lightminn/ZETIN_Drone/scripts/README.md

# PC 지상국·분석 도구

현행 `dual_imu_cascade_pwm`용 조종·텔레메트리 수집·오프라인 분석 도구다.
처음 시작하면 [전원 인가 벤치 절차](../docs/power_on_bench_procedure.md)를
먼저 읽고, USB로 연결한 DualSense와 `control_dualsense.py`를 사용한다.
이 문서는 2026-09-07 저장소 코드 기준이며 현재 기체에 올라간 빌드나 실기
통과 여부를 뜻하지 않는다. 명령·필드 순서·단위의 정본은
[UDP 프로토콜](../docs/udp_protocol.md)이다.

## 무엇을 실행할까

아래 명령은 저장소 루트에서, 필요한 패키지가 설치된 Python 환경으로 실행한다.
의존성은 [requirements.txt](../requirements.txt)에 있다. `motor_serial.py`는
추가로 `pyserial`이 필요하다.

| 목적 | 도구 | 실행 조건과 출력 |
|---|---|---|
| 조종·stdin 명령·CSV·raw 기록 | `control_dualsense.py` | 현행 기본 지상국. 게임패드 USB 연결, `Drone_Tuning` 접속 |
| 축·버튼 번호 확인 | `gamepad_probe.py` | 드론에 명령을 보내지 않음. 처음 0.7초 손을 떼고 각 입력을 하나씩 확인 |
| 입력값 연속 표시 | `test_dualsense_input.py` | 로컬 입력 진단. 화면의 RX/RY/L2 라벨은 예시 매핑이므로 축 번호를 실측 |
| 게임패드 없는 수동 UDP 콘솔 | `tune_pid.py` | 명령 1회 송신과 상태 표시. RC 자동 송신·CSV 기록·종료 시 자동 `stop` 없음 |
| 텍스트 수신·CSV 기록 | `receive_telemetry.py` | 단독 수신 전용. 조종·정지 명령 없음 |
| 실시간 그래프·CSV 기록 | `monitor_telemetry.py` | GUI 필요. 조종·정지 명령 없음 |
| 비행 CSV 요약·그래프 | `analyze_flight_log.py` | 오프라인. 대상 `flight_log_*.csv` 경로를 명시 |
| 프로브 분포 분석 | `analyze_probe_response.py` | 오프라인 연구용. 결과가 현행 착지컷에 연결되지는 않음 |
| raw 바이너리 → CSV | `decode_imu_raw.py` | 오프라인. 원본 `.bin` 보존, 출력 CSV 생성/덮어쓰기 |
| 자기계 보정 상수 계산 | `magcal_fit.py` | 보정용 raw CSV에서 상수를 출력. 펌웨어를 자동 수정하거나 업로드하지 않음 |
| dual-IMU 루프 진단 | `receive_dual_imu_debug.py` | 전용 `icm42670_dual_loop_debug` 펌웨어·`DUAL_IMU_DEBUG` AP용 |
| 모터 식별용 시리얼 조작 | `motor_serial.py` | 전용 `motor_id_single` 펌웨어, 프로펠러 제거·PSU 전류 제한. 지정 시리얼 포트 확인 |

**드론에 UDP를 보내는 도구는 한 번에 하나만 실행한다.** 펌웨어는 마지막
발신자의 IP/포트를 텔레메트리 목적지로 삼는다. 포트 충돌을 피했더라도
`tune_pid.py`나 수신기의 `connect`가 조종 지상국의 데이터를 가져갈 수 있다.
DualSense 조종 중 상태 확인과 로그 기록도 같은 `control_dualsense.py`에서 한다.

`receive_telemetry.py`와 `monitor_telemetry.py`는 현재 raw 바이너리 분기가
없다. 펌웨어 raw가 켜져 있으면 `ZIMU`·`ZCAL`을 불량 텔레메트리로 집계하며
저장하지 않는다. raw까지 받을 세션은 `control_dualsense.py`를 사용한다.
독립 수신기만 사용할 벤치에서는 모터를 정지한 채 기존 콘솔에서 `raw off`
(`tune_pid.py`에서는 `raw 0`)를 보내고 그 콘솔을 종료한 뒤 수신기를 실행한다.
이 설정은 드론 재부팅 후 유지되지 않는다.

## DualSense 시작·조종·정지

```bash
python scripts/gamepad_probe.py
python scripts/control_dualsense.py
```

첫 명령을 종료한 다음 두 번째 명령을 실행한다. 실행만으로 시동하지 않는다.
`[STATUS]`의 자세·`Armed`·`Faults`를 확인하고 벤치 절차의 시동 조건을 따른다.
게임패드 없이 시작하면 조종 스레드는 종료하지만 stdin·수신은 남는다. 이때
stdin `start`만으로 주기적인 RC가 생기지는 않으므로 비행 조종에 사용하지 않는다.

| 입력 | 현행 동작 |
|---|---|
| X | 지상국이 무장 상태로 보면 `stop`, 아니면 `start` 요청 |
| △ | 자동착륙 하강 중 명시적 `resume` 시도 |
| 왼쪽 스틱 | roll/pitch 목표 각도, 최대 ±15° |
| 오른쪽 스틱 좌우 | yaw 각속도, 최대 ±90°/s. 상하는 사용하지 않음 |
| R2 / L2 | 눌림으로 판정된 동안 스로틀 증가/감소, 일정한 200µs/s |
| R1 / L1 | 누름 엣지마다 스로틀 +1 / −1µs |
| D-pad | roll/pitch 트림 0.2°씩 변경, 각 축 ±10° 제한 |
| PS | 트림을 0으로 초기화 |
| stdin `stop` | 지상국의 무장 추정과 무관하게 `stop` 반복 전송 |
| Ctrl+C | 지상국이 무장 상태로 보는 경우 `stop` 후 종료·로그 닫기 |

RC `rcr` 송신 목표는 **20Hz**(`CTRL_LOOP_HZ=20`)다. 스로틀과 트림 입력은
RC 송신 중에만 처리된다. 버튼 번호는 OS/연결 방식에 따라 확인해야 하며,
현재 코드는 X=b0, △=b3, PS=b12, R1=b5, L1=b4, R2=a5, L2=a2를 쓴다.

stdin에는 [프로토콜의 명령](../docs/udp_protocol.md#지상국--드론)을 입력한다.
`start`·`stop`·`resume`·`th`는 지상국 상태도 함께 갱신하는 별도 경로다.
자기계와 raw 토글은 이 콘솔에서 **`mag on/off`, `raw on/off`**로 입력한다.
그 외 PID 게인, `gains`, `yaw`, `magcal`, `magc` 등은 UDP로 전달된다.
명령 전송 메시지나 `ARMED` 배너는 ACK가 아니다. 실제 적용은 `Armed`,
`Mag_Enabled`, `Trim_*`, `GAINS` 응답 등 해당 텔레메트리로 확인한다.

## 링크가 끊겼을 때

게임패드 분리, 유효 텔레메트리 1.5초 미수신, `Fault_RC` 상승 엣지는
**RC 송신만 중단**한다. 로컬 스로틀은 초기화하지만 `th 1000`이나 `stop`을
자동으로 보내지 않는다. 펌웨어는 자체 RC 타임아웃 조건에 따라 즉시 컷 또는
시간 기반 하강을 수행한다. 하강은 착지를 감지하지 않으며 자세한 조건과
시간 예산은 [프로토콜](../docs/udp_protocol.md)에 있다.

수신·패드 연결이 돌아와도 RC가 자동 재개되지는 않는다. 같은 지상국 세션이
드론을 무장 상태로 보고 있고, 최신 `Failsafe_Phase=1`과 유효한 `Hover_Est`가
있을 때 △ 또는 stdin `resume`으로 복구를 요청한다. 지상국은 RC 송신을 먼저
재개하고, 카운터로 RC 수락을 확인한 뒤 `resume`을 보낸다. 이후 추가 RC
수락과 `Failsafe_Phase=0`을 확인해야 성공을 출력하고 로컬 스로틀을 호버
추정치에 맞춘다. **복귀는 고도·하강속도 복구를 보장하지 않는다.**

확인 시간 초과 메시지는 성공을 뜻하지 않는다. 해당 실패 처리만으로는
재개했던 RC 송신이 꺼지지 않을 수 있으며, 실제 phase를 다시 봐야 한다.
킬이나 재상실은 진행 중 복구를 취소한다. 펌웨어가 이미 컷한 뒤에는
`resume`할 수 없다. 지상국을 재시작하면 로컬 무장 추정도 초기화되므로
비행 중 프로세스 재시작을 복구 절차로 사용하지 않는다.

수동 킬은 stdin `stop`·X·Ctrl+C 경로다. 단 X는 로컬 무장 추정에 따른
토글이므로 **항상 정지만 요청하려면 stdin `stop`**을 사용한다.
드론의 `Armed=0` 확인(시동 직후 유예 제외)이나 `Fault_Critical` 상승 엣지도
지상국 무장 추정이 남아 있으면 `stop`을 보낸다. 자세한 링크 진단은
[지상국 링크 문서](../docs/ground_station_link.md)를 따른다.

## 상태·트림·자기계 읽기

`[STATUS]`는 수신된 상태를 약 1초마다, 무장 중 `[DIAG]`는 약 5Hz로 표시한다.
하강 중 `[AUTO-LAND]`는 매 텔레메트리 샘플을 표시하고 종료 phase는 전이 때
한 번 출력한다. 없는 구형 필드는 `-` 또는 `legacy/unknown`이며 정상값 0이 아니다.

- `Mag=`는 지상국 선택이 아닌 실제 `Mag_Enabled`다. 펌웨어 부팅 기본은 OFF,
  지상국 선택 기본은 ON이다. 시동 요청 전에 선택값을 다시 보낸다.
  OFF 선택으로 시작하려면 `--no-mag`를 쓴다. 기존 벤치 결과와 현재 보정 후
  재검증 범위는 [BMM350 문서](../docs/bmm350_yaw_bench_test.md)에서 확인한다.
- `AGL=`은 거리계 표시다. 신선도 없음은 `-`, 음수 거리 원값은 `OOR/q<품질>`,
  그 외는 `1.23m/q200`처럼 표시한다. 거리·광류는 현재 기록용이며 자동 고도
  제어·착지 판정에 사용하지 않는다.
- `eR/eP`는 목표 각도에서 측정 각도를 뺀 값이다. 목표에는 트림이 이미 포함된다.
  `dG`는 두 IMU의 축별 gyro 차이 중 최댓값이다. 이 20Hz 스냅샷으로 빠른
  프롭 진동·순간 센서 고장을 확정할 수 없다.
- `Trim=`은 드론이 보내온 값이다. 로컬 값과 다르면 `!`가 붙고 0.2초 이상
  간격으로 재전송한다. 유실·거부가 계속되면 표시도 남는다. 첫 완전한 트림
  텔레메트리를 한 번 채택한 뒤에는 로컬 값을 유지하므로 **stdin `trim`이나
  드론 재부팅으로 바뀐 값을 다시 덮어쓸 수 있다.** 같은 세션의 트림 변경은
  D-pad·PS를 사용한다. `start`는 트림을 따로 보내지 않는다.

## 로그 저장과 오프라인 분석

기본 지상국은 `logs/flight_log_<timestamp>.csv`를 기록한다. raw를 처음
받았을 때 같은 타임스탬프의 `imuraw_<timestamp>.bin`을 열고 데이터그램을
그대로 이어 쓴다. 종료 시 `.bin`을 닫고 같은 이름의 `.csv`로 변환한다.
변환 실패는 경고하며 원본 `.bin`은 남는다. 시간은 로그 크기와 실행 환경에
따라 달라진다. 코드의 “10분 세션 약 12초”는 안내값이다.

```bash
python scripts/control_dualsense.py --no-raw --no-mag
python scripts/analyze_flight_log.py logs/flight_log_YYYY-MM-DD_HHMMSS.csv --no-plot
python scripts/decode_imu_raw.py logs/imuraw_YYYY-MM-DD_HHMMSS.bin /tmp/imu.csv
python scripts/analyze_probe_response.py ground.csv air.csv --label ground --label air
python scripts/magcal_fit.py capture.csv
```

각 명령은 서로 별도 용도다. `--no-raw`는 시작 시 `raw 0`을 반복 전송하며
세션 내 raw 파일 기록을 막는다. 이후 `raw on`은 펌웨어 게이트만 켜므로
`--no-raw`로 시작한 세션의 기록을 다시 켜지는 않는다. 기본 실행도 `raw 1`을
자동 재전송하지 않으므로 이전 세션이 껐다면 `raw on`을 직접 입력한다.

`analyze_flight_log.py`의 `--no-plot`은 창을 생략하지만 matplotlib은 여전히
필요하다. 파일을 생략하면 `logs/*.csv` 중 수정시각이 가장 최근인 파일을
선택하므로, raw CSV를 고르지 않도록 경로를 명시한다.

프로브 분석은 실행 시 현재 `.ino`에서 임계를 읽는다. 과거 비행 당시 임계와
같다는 뜻은 아니다. 20Hz에서 관측된 상태 전이 또는 응답값 변화로 이벤트를
추출하므로 일부 이벤트를 놓칠 수 있다. `BLOCKED`·0 응답을 제외하고,
표본 부족·`Hover_Est` 혼합은 판정을 보류한다. 종료코드 0은 분석 실행 성공이며
분포 “통과”를 뜻하지 않는다. `--plot`일 때만 matplotlib을 불러온다.

`magcal_fit.py`는 기본적으로 `Mag_Cal_Active=1`인 raw 행만 사용한다.
`--all`은 보정 전 raw만 따로 추린 파일임을 확인했을 때만 사용한다. 출력의
`95p |B| radial residual`은 자기장 크기 피팅 잔차로, heading 정확도가 아니다.
스로틀 간섭 계수 환산은 입력 좌표계가 맞아야 하며 새 보정 후 모터 벤치로
재검증한다. 로그 좌표계·시간축·결측 해석은 [logs/README.md](../logs/README.md).

## 자동 벤치 스크립트의 실행 범위

`bench_sign_test.py`·`bench_yaw_test.py`·`bench_thrust_ramp.py`는 이전 벤치의
자동화 도구다. 세 스크립트 모두 **WiFi 전환, `trim 0 0`, `start`, 주기적 RC,
종료 시 `stop`**을 실행한다. 출력 경로와 복귀 SSID가 코드에 고정되어 있고
WiFi 복귀 성공을 충분히 확인하지 않은 채 완료를 출력한다. 새 환경에서
그대로 실행하는 첫 진입점으로 사용하지 말고
[현행 벤치 절차](../docs/power_on_bench_procedure.md)와 설정을 먼저 대조한다.

- `bench_sign_test.py`·`bench_yaw_test.py`: 모터 전원 차단·프로펠러 제거 상태의
  텔레메트리 부호 확인용이다. 이 전제를 코드가 물리적으로 확인하지 않는다.
- `bench_thrust_ramp.py`: 프로펠러가 회전하는 고정 시험용이다. EOF에서도
  확인 입력을 통과하고, 종료 램프는 고정 `1200 → 1100 → 1000`이어서 지정한
  `cap_us`가 1200보다 작아도 그 값을 넘을 수 있다. 20Hz 모터 명령 분산에
  근거한 “진동 없음”·다음 시험 권고 출력은 기계 진동·실제 추력·비행 안전의
  검증으로 취급하지 않는다. 이 제한을 해결하기 전에는 초보자 실행 경로에서
  제외한다.

공유 모듈은 `telemetry_schema.py`(파싱·CSV 정규화)와
`failsafe_telemetry.py`(phase·probe 이름과 표시)다. 이들은 실행 도구가 아니다.
[archive/](archive/README.md)의 GPS/TCP 도구는 현행 비행 펌웨어용이 아니다.
