lightminn/ZETIN_Drone/docs/superpowers/plans/2026-07-28-failsafe-vertical-state-strategy.md

# 자동착륙 취약점 8건 해소 전략

2026-07-28. 코드리뷰 수정(커밋 358f2ef~54d6d9c) 이후 남은 구조적 취약점 8건의
해소 전략. 개별 패치 목록이 아니라 **의존 순서가 있는 3개 층**이다.

## 0. 8건은 독립적이지 않다

| # | 취약점 | 뿌리 | 해소되는 곳 |
|---|---|---|---|
| 1 | 임계값이 호버 추력에 비연동 | 수직 상태 없음 | Layer 1 |
| 2 | `saw_impact`에 시간 제약 없음 | 수직 상태 없음 | Layer 1 (문제 소멸) |
| 3 | 지면효과 오검출 | 수직 상태 없음 | Layer 1 (문제 소멸) |
| 4 | `safety_lock` 양 코어 경합 | 독립 | Layer 2 |
| 5 | 타임아웃이 사실상 주 경로 | 수직 상태 없음 | Layer 1 |
| 6 | `Failsafe_Phase` 소비자 없음 | 관측 불가 | Layer 0 |
| 7 | 가속도 보정 없음 | — (Layer 1의 전제) | Layer 1 |
| 8 | 복구 경로 없음 | 독립 | Layer 2 |

1·2·3·5는 한 뿌리다 — **failsafe가 기체의 수직 상태를 모른다.** 고도도
수직속도도 호버추력 추정도 없으니 변하는 양을 고정 상수로 대신하고 있다.

### 왜 적분이 답인가

원래 설계가 실패한 지점이 여기다. 등속 하강과 정지는 **순간** 가속도로
구분되지 않는다(둘 다 1g). 그러나 적분하면 구분된다:

- 등속 하강: `|a| = 1g`, `v_z = 상수 ≠ 0`
- 접지 후 정지: `|a| = 1g`, `v_z = 0`

스파이크 검출은 이 정보를 못 쓰기 때문에 택한 우회로였다. 지면효과도
마찬가지로 갈린다 — 지면효과는 하강을 **감속**시키지만 **정지시키지는
못한다.** v_z는 그 차이를 본다.

### 실현 가능성 검산

`v_z`를 적분으로 얻을 때 지배적 오차원을 따져야 한다.

**자세 오차는 문제가 아니다.** 자세 추정이 θ만큼 틀려도 수직 성분은
`1g·cos(θ)`이므로 오차가 θ의 2차다. θ=2°면 0.0006g = 0.006 m/s², 5초
적분해도 0.03 m/s. (`g·sinθ`는 수평 누설이지 수직이 아니다.)

**지배적 오차는 가속도 스케일 하나다.** 현재 실측 바이어스 +0.8%
(정지 시 `|a|` 중앙값 1.007~1.009g) = 0.078 m/s² → 5초에 **0.39 m/s**.
목표 하강률 0.4 m/s와 같은 크기라 보정 없이는 쓸 수 없다.

정지 시 `|a|`로 스칼라 스케일 보정(`k = 1/|a|_rest`)을 하면 잔차는 0.1%
수준 → 5초에 0.05 m/s. 하강률 대비 12%로 충분하다. **그래서 7번이 선택이
아니라 전제조건이다.**

진입 시 `v_z = 0`으로 리셋하므로 적분 구간은 하강 5초로 제한된다. 비행
전체를 적분하지 않는다.

⚠️ `FS_MAX_MS`를 10초로 올리면 드리프트도 2배(0.1 m/s)가 된다. 판정
임계를 그에 맞춰 재검토해야 한다.

### 스칼라 스케일 보정의 한계 (의도적 선택)

축별 오프셋 보정은 6면 캘리브레이션이 필요하고, 정지 1회 측정으로는
자세를 모르므로 3축 분리가 불가능하다. 반면 **착지 판정과 v_z 모두 `|a|`
기반**이므로 스칼라 스케일만으로 관측된 오차의 대부분을 제거한다. 축별
오프셋은 별도 과제로 남긴다(현재 근거 없음).

## Layer 0 — 관측 가능하게 만들기

**이게 없으면 나머지는 추측이다.** Layer 1의 모든 항목이 여기에 의존한다.

### 0-A. SIL 플랜트에 수직 동역학 추가
`PlantState`에 `z`, `v_z`. 스로틀→추력 모델, 지면 접촉(반력·정지), 지면효과
(고도에 따른 추력 증배)를 넣는다.

지금은 자동착륙을 검증할 수 있는 곳이 실기밖에 없다. 이걸 만들면 하강,
착지, **공중 오검출**, 타임아웃을 전부 자동 검증할 수 있고, 위험해서 실기로는
재현하면 안 되는 시나리오를 안전하게 돌릴 수 있다.

검증 대상 시나리오(최소):
- 정상 하강 → 접지 → `FS_CUT_LANDED`
- 진입 스로틀이 호버보다 높음 → 상승 → 현재 코드로는 타임아웃 (1번 재현)
- 지면효과 구간 통과 중 오검출하지 않음 (3번 재현)
- 돌풍 스파이크 후 잔잔한 구간 → 오검출하지 않음 (2번 재현)

**먼저 현재 코드로 위 넷을 돌려 1·2·3번이 실제로 재현되는지 확인한다.**
재현되지 않으면 내 분석이 틀린 것이므로 Layer 1 설계를 재검토한다.

### 0-B. ~~하강 구간 고속 캡처~~ → **불필요해짐 (2026-07-28)**

착지 판정이 1-C′ 능동 프로브로 바뀌면서 이 항목의 근거가 사라졌다.

관측 대상이 **10~100ms 접지 스파이크 파형**에서 **프로브당 스칼라 응답
하나**로 바뀌었다. 프로브는 400ms마다 일어나고 텔레메트리는 50ms 주기이므로
각 응답이 8회씩 샘플링된다. `Failsafe_Probe_Response_G`(43번 필드)로 이미
나가고 있어 E-4a의 분포 측정에 충분하다.

**보류 조건**: E-4a에서 지면/공중 응답 분포가 겹쳐 원인 진단이 필요해지면
그때 만든다. 그 경우에도 기압센서 쪽이 먼저 검토 대상이다.

### ~~0-B 원안~~ (기록용)
텔레메트리는 50ms(20Hz)인데 접지 스파이크는 10~100ms다. **현행 로그로는
스파이크를 볼 수 없다** — 지금 `docs/power_on_bench_procedure.md` Stage E-4가
지시하는 측정은 실행 불가능하다.

하강 중 원시 `|accel|`(및 `v_z` 추정치)을 1kHz 링버퍼에 담고 컷 이후 UDP로
덤프한다. 5초 × 1kHz × float 2개 = 40KB — RAM 여유(현재 17% 사용) 안이다.
전송은 컷 이후이므로 비행 중 부하가 없다.

이게 `FS_LAND_*` 상수 확정의 유일한 근거다.

### 0-C. `Failsafe_Phase` 표시
`monitor_telemetry.py`와 `analyze_flight_log.py`가 이 필드를 **0번 참조**한다.
그런데 Stage E는 조종자에게 비행 중 실시간으로 보라고 한다. 두 도구에
`Failsafe_Phase`·`Trim_Roll`·`Trim_Pitch`를 추가한다. → **6번**

가장 싸고 벤치를 당장 막고 있는 항목이다.

## 0-A 관문 결과 (2026-07-28, 현재 펌웨어 그대로 측정)

SIL에 수직 동역학을 넣고 V1~V4를 **펌웨어 수정 전에** 돌린 결과다.

| | 시나리오 | 결과 | 판정 |
|---|---|---|---|
| V1 | 정상 하강 | `CUT_LANDED` 2.92s, 접지 1.58s | 5번 **재현 안 됨** |
| V2 | 상승 중 링크 끊김 | **고도 +25.98m**, 27.4m에서 컷 | 1번 **재현** |
| V3 | 지면효과 | 기체가 오히려 상승(+0.82m) | **판정 불가**(시나리오 오설정) |
| V4 | 돌풍 후 잔잔 | 접지 2.309s, **컷 1.901s** (공중 1.0m) | 2번 **재현** |

### 취약점 5는 이미 해소됐다

"모든 자동착륙이 타임아웃으로 끝난다"는 주장은 **구 코드(±0.05g)에 대해서만
맞았다.** 실측 로그로 400ms 확정창이 통째로 허용오차 안에 들어오는 비율:

| 로그 | ±0.05g (구) | ±0.10g (현) |
|---|---|---|
| 040715 | 66.5% | 95.6% |
| 040904 | 68.5% | 92.7% |
| 041032 | 84.9% | 97.1% |

커밋 4174172의 허용오차 확대만으로 안정 조건은 실현 가능해졌다. V1의 성공은
SIL 인공물이 아니라 실측이 뒷받침한다.

⚠️ 부수 정정: LPF가 노이즈를 크게 줄일 것이라는 최초 계산은 **백색잡음
가정이라 틀렸다.** 실측에서 5Hz LPF는 sd를 0.0503 → 0.0470으로 거의 줄이지
못한다. 노이즈의 지배 성분이 5Hz 아래의 실제 기체 운동이기 때문이다.

### 그런데 이게 반대편을 악화시킨다

안정 조건이 쉬워진 만큼(93~97%) 공중 오검출을 막는 것은 `saw_impact` 하나뿐이다.
그리고 V2가 그 문지기가 헐겁다는 것을 보여줬다.

**신규 취약점 9 — `saw_impact`는 접지에 특이적이지 않다.** V2에서 기체가
상승하는 동안 0.501s에 `saw_impact`가 섰다. 상승 가속도가 1g+0.25g를 넘었기
때문이다. 지면 반력이든 상승 가속이든 돌풍이든 **위쪽 가속이면 무엇이든**
접지 증거로 채택된다.

정리하면 같은 결론이다:
- 구 코드: 너무 엄격 → 안 걸림 (취약점 5)
- 현 코드: 안정 조건은 쉬워졌으나 문지기가 비특이적 → **공중에서 걸림** (취약점 2·9)

**가속도 크기만으로는 이 일을 할 수 없다.** Layer 1(v_z)이 유효하다.

### 0-A′ 후속 측정 (진동 모델 + V3 재설계)

SIL에 실측 기반 저주파 진동 모델(기본 OFF, 결정적)을 넣고 다시 측정했다.

**취약점 3 — 반증.** V3를 실제로 하강하게 고쳐 `k_ge`를 0.15/0.25/0.35로 훑었다.

| `k_ge` | 접지 전 최대 \|accel\| | 임계 | 접지 전 impact |
|---|---|---|---|
| 0.15 | 1.0059g | 1.25g | 없음 |
| 0.25 | 1.0254g | 1.25g | 없음 |
| 0.35 | 1.1089g | 1.25g | 없음 |

메커니즘이 분명하다: **하강 스로틀 부족분(−60µs ≈ 추력 −14%)이 지면효과
증가분을 상쇄한다.** 지면효과는 기껏해야 1g 쪽으로 되돌릴 뿐 임계를 넘기지
못한다. 취약점 3은 목록에서 닫는다.

**취약점 5 — 반증(이미 해소).** 노이즈 sd를 0.02/0.04/0.06g로 훑어도 V1은
계속 `FS_CUT_LANDED`로 착지했다. 다만 **검출이 0.71초 지연**된다(2.925s →
3.642s). 0.06g 위의 여유는 이 스윕으로 주장할 수 없다.

**취약점 2·9 — 확정.** V4는 노이즈 ON/OFF 무관하게 **정확히 같은 1.901초**에
공중 컷했다(접지 2.309초, 약 1m 상공). 노이즈가 원인이 아니라 **로직이
원인**이라는 뜻이다.

### v_z 적분의 타당성 (실측으로 확인)

저주파 노이즈를 적분하면 랜덤워크가 커져 v_z가 못 쓸 것이라는 우려가 있었다.
모터 OFF 정지 구간에서 **센서 노이즈 바닥**을 재보니:

    센서 노이즈 바닥 = 0.0006 g   (무장 중 관측 0.03~0.05g보다 두 자릿수 작음)

즉 무장 중의 0.04g는 거의 전부 **실제 기체 운동**이지 센서 오차가 아니다.
실제 운동은 v_z가 추적해야 할 신호지 오차가 아니다. 센서 노이즈만의 적분
드리프트는 τ=0.2s, T=10s에서도 **0.012 m/s**로 무시할 수 있다.

따라서 v_z의 지배 오차는 여전히 **스케일 오차 하나**(0.8% → 5초에 0.39 m/s)이며
1-A로 잡는다. **Layer 1은 실현 가능하다.**

### 갱신된 취약점 현황

| # | 상태 |
|---|---|
| 1 | **확정** (V2: +25.98m 상승) → 1-B |
| 2 | **확정** (V4: 공중 1m 컷, 노이즈 무관) → 1-C |
| 3 | **반증** — 하강 스로틀 부족분이 지면효과를 상쇄. 닫음 |
| 4 | 미측정 (경합) → 2-A |
| 5 | **반증** — 커밋 4174172로 이미 해소. 닫음 |
| 6 | **완료** (커밋 a6599cd) |
| 7 | v_z의 전제조건 → 1-A |
| 8 | 미측정 (복구 경로) → 2-B |
| 9 | **확정** (V2: 상승 중 `saw_impact`) → 1-C |

8건 중 **2건이 반증되어 닫혔고 1건은 완료**됐다. 남은 것은 1·2·4·7·8·9다.

### 남은 숙제

- **V3 재설계**: 진입 스로틀이 호버보다 높아 기체가 상승해버렸다. 지면효과
  구간을 실제로 통과하도록 다시 짜야 3번을 판정할 수 있다.
- **SIL에 진동 모델이 없다**: 현재 accel 주입은 2 LSB dither뿐이라 실측 sd
  0.03~0.05g보다 훨씬 깨끗하다. V1~V4를 현실적으로 만들려면 실측에 맞춘
  노이즈를 넣어야 한다. 특히 **오검출 시나리오는 노이즈 없이는 낙관적으로
  나온다.**
- `k_ge=0.15`(추력 +15%)는 임계 0.25g보다 작아 지면효과만으로는 `saw_impact`를
  못 세운다. 실제 지면효과는 최대 +30%까지 가므로 파라미터 의존적이다.
- `LandDetector`가 `pid_task` 지역변수라 계측 seam이 없어 SIL이 shadow 복제본을
  돌려야 했다. 검증 신뢰도를 위해 관측 가능하게 만드는 편이 낫다.

## Layer 1 — 상수를 추정으로 대체

### 1-A. 가속도 스케일 보정 → **7번**
`calibrate_bias()`는 이미 정지 대기를 하고 자이로만 보정한다. 같은 정지
구간에서 `|a|`를 평균해 `accel_scale = 1.0 / |a|_rest`를 구해 적용한다.
움직임 판정(`BIAS_MOVEMENT_THRESH`)은 그대로 재사용한다.

검증: 보정 후 정지 `|a|` 중앙값이 1.000±0.002g인지.

### 1-B. 호버 스로틀 추정기 → **1번**
무장 상태에서 수평이고 `|a| ≈ 1g`가 유지되는 동안의 스로틀이 곧 호버 추력이다.
이를 LPF로 계속 추적한다(`hover_throttle_est`).

그 위에서 두 상수를 **상대값으로** 바꾼다:
- 하강 목표 = `hover_throttle_est − FS_DESCENT_DELTA_US`
  (진입 스로틀이 아니라 **호버 추정치** 기준. 조종자가 상승 중이었어도
  실제로 하강한다.)
- 지상컷 판정 = `base_throttle < hover_throttle_est − FS_GROUND_MARGIN_US`

추정치가 없을 때(무장 직후, 아직 호버한 적 없음)의 폴백이 필요하다:
추정 유효 플래그가 서기 전이면 **지상으로 간주해 즉시 컷**한다. 호버한 적이
없으면 공중에 있을 수 없다는 논리로, 안전한 쪽 폴백이다.

### ~~1-C. 수직속도 기반 착지 판정~~ → **폐기 (2026-07-28)**

원안은 진입 시 `v_z = 0` 리셋 후 적분해 "`v_z`가 0으로 돌아오면 접지"로
판정하는 것이었다. **수학적으로 틀렸다.** 구현 중 발견했다.

```
v̂z(t) = ∫[진입→t] a_z dt = vz(t) − vz(진입)
```

진입 시 0으로 리셋하면 얻는 것은 절대 수직속도가 아니라 **진입 시점 대비
변화량**이다. 지면에 정지해 있어도 `v̂z = −vz(진입)`이지 0이 아니다.
"`v_z`가 0으로 돌아온다"는 실제로는 "`vz`가 진입 때와 같아진다"를 뜻한다.

전제가 통째로 무너지진 않았다. 호버 중 링크가 끊기면 `vz(진입) ≈ 0`이라
동작한다. 깨지는 것은 진입 시점에 이미 수직으로 움직이던 경우 — **정확히
V2(상승 중)와 V4(하강 중)**, 즉 고치려던 바로 그 시나리오다.

측정도 일치했다. 명세대로 구현하니 V1·V2가 전부 타임아웃으로 갔고, 접촉
충격으로 보조 재고정을 넣으니 바운스가 추정치를 −0.22~−0.36 m/s로 밀어 V1이
다시 실패했다.

**근본 한계**: 가속도계만으로는 "지면 정지 + 스로틀 호버 미만"과 "종단속도
등속 하강"이 정상상태에서 구분되지 않는다. 둘 다 정확히 1g이고 차이는
과도구간뿐인데 돌풍이 그것을 흉내낸다. 적분해도 상대량만 얻으므로 이 벽을
넘지 못한다.

### 1-C′. 능동 스로틀 프로브 (채택) → **2·9번**

수동 관측으로 구분이 안 되면 **능동 시험**으로 구분한다.

**원리**: 지면에 있으면 반력이 추력 변화를 흡수해 스로틀을 더 낮춰도
`|accel|`이 1g에 머문다. 공중이면 추력을 줄이는 즉시 아래로 가속해 1g 미만이
된다. 관측이 아니라 개입이므로 **관측 불가능성 자체가 사라진다.**

**절차**
1. `FS_MIN_DESCEND_MS` 이후부터 `FS_PROBE_PERIOD_MS`(초기 400ms)마다 프로브.
2. `base_throttle`을 `FS_PROBE_DIP_US`(초기 40µs) 낮춰
   `FS_PROBE_DIP_MS`(초기 120ms) 유지.
3. 딥 **직전** LPF된 `|accel|`과 딥 **중**(필터 지연 회피로 앞 ~30ms 제외)
   값의 **차분**을 잰다.
4. 차분 > `FS_PROBE_RESPONSE_G`(초기 0.06g)면 "반응함" = 공중.
5. **연속 `FS_PROBE_CONFIRM_N`회(초기 2) 무반응이면 착지 확정.**

**수치 근거**: 호버 1340µs는 아이들 대비 340µs다. 40µs 딥은 추력의 11.8%
= 0.118g. LPF 잔차 노이즈 0.047g 대비 절대값 판정은 2.5σ로 얇지만, **딥 직전
대비 차분**은 저주파 노이즈가 상쇄돼 훨씬 안정적이다(노이즈의 지배 성분이
5Hz 아래라 400ms 안에서는 거의 공통모드다).

공중에서 딥 120ms 동안의 추가 하강은 0.118g × (0.12s)²/2 ≈ **0.008m**로
무시 가능하다.

**자연히 해결되는 것**
- 돌풍: 프로브 타이밍은 우리가 정하고 돌풍은 그와 무관하다. 연속 2회
  무반응 요구로 오검출 확률이 급감한다.
- 바운스: 튀어 오른 동안은 공중이라 프로브가 반응한다 → 착지로 오인하지
  않는다. 안정 기반 방식이 못 하던 것이다.
- 사람이 붙잡은 경우: 무반응 → 컷. 바람직한 동작이다.
- 진입 시점 수직속도: **무관하다.** 절대 속도를 알 필요가 없다.

**실패 방향이 안전하다.** 프로브가 계속 반응하면(공중) 착지를 선언하지 않고
타임아웃으로 간다. 무반응이어야만 컷한다.

**가드**: `base_throttle − FS_PROBE_DIP_US < 1000`이면 딥을 만들 수 없어
판별 불가다. 프로브를 건너뛰고 타임아웃 백스톱에 맡기되 그 사실을
텔레메트리로 드러낸다.

**남는 위험**: 키 큰 풀처럼 부분적으로 받치는 지면에서는 반응도 부분적이다.
`FS_PROBE_RESPONSE_G`가 그 경계를 정하며 벤치 조정 대상이다.

### 1-C′ 측정 결과와 **가장 큰 남은 위험** (2026-07-28)

SIL에서 전 시나리오가 통과했다(25/25). V4의 공중 컷이 사라졌고(접지 5.181s
→ 컷 6.221s), V2의 접지~컷 지연이 1.794s → **0.959s**로 줄었으며, 신규 V5는
바운스 중 프로브가 0.1147g로 반응해 무반응 카운트를 1→0으로 리셋하는 것을
확인했다 — 설계가 주장한 바로 그 동작이다.

**그러나 판정 여유가 얇다.**

| | 프로브 응답 |
|---|---|
| 지면(정착 후) | 0.0379 ~ 0.0512g |
| 공중 | 0.0625 ~ 0.1390g |
| 임계 | **0.0600g** |

최대 지면 응답(0.0512g)과 최소 공중 응답(0.0625g)의 간격이 **0.011g뿐이다.**
지면이 완전히 무응답이 아닌 이유는 물리적이다 — 추력이 줄면 착륙장치(SIL에서는
스프링-댐퍼)가 살짝 더 눌리며 과도응답을 낸다. 실제 기체도 같다.

따라서 **`FS_PROBE_RESPONSE_G`와 `FS_PROBE_DIP_US`는 벤치 실측 없이 신뢰할 수
없다.** 위 수치는 추정 파라미터(질량 0.3466kg, `k_ground` 80N/m)에 의존한다.

벤치에서 확정할 것:
1. 지면에 놓고 자동착륙을 유도해 **지면 응답 분포**를 잰다(수십 회).
2. 손에 들고(공중 대용) 같은 것을 재 **공중 응답 분포**를 잰다.
3. 두 분포가 겹치면 `FS_PROBE_DIP_US`를 키운다(40→60µs면 응답이 1.5배).
   `CTRL_MARGIN`(150) 미만이어야 하며 `static_assert`가 강제한다.
4. 겹침이 해소되지 않으면 **기압센서를 다는 편이 옳다.** 그때는 프로브를
   제거하고 고도원으로 교체한다.

여유가 얇은 쪽으로 틀리면 **타임아웃 컷**이 되므로 실패 방향은 안전하다.
공중 오검출이 되려면 공중에서 연속 2회 응답이 임계 아래로 떨어져야 하는데,
측정된 공중 최소값 0.0625g는 임계 바로 위다 — **이 경계가 벤치의 최우선
확인 항목이다.**

## Layer 2 — 구조 정리 (Layer 0·1과 독립)

### 2-A. `safety_lock` 단일 writer → **4번**
`fs_phase`와 같은 모양의 경합이 그대로 남아 있다. `pid_task`가 765·836·859·
894행에서 `true`를, `udp_task`가 1252행에서 `false`를 쓴다. `fs_phase`에
적용한 것과 같은 방식(요청 플래그를 Core 0이 세우고 실제 전이는 Core 1이
수행)으로 정리한다.

### 2-B. 복구 경로 → **8번**
링크가 살아나도 자동 복귀는 위험하다(하강 중 재진입 반복). 명시적 `resume`
명령으로만 `FS_DESCENDING → FS_NONE` 복귀를 허용한다. 조건: RC가 실제로
살아있고(최근 수신), 자세가 정상이며, IMU가 살아있고, `hover_valid`일 것.

복귀 스로틀은 `hover_est`로 둔다. 하강 스로틀 그대로면 조종자가 `th`를 보낼
때까지 계속 내려가고, 임의로 높이면 튀어오른다. `hover_est`가 유일하게 근거
있는 값이다.

#### ⚠️ resume은 고도를 되찾지 못한다 (2026-07-28 정정)

최초 합격 기준을 "하강이 멈추고 고도가 유지되는지"로 썼는데 **틀렸다.**
`hover_est`는 하강 **가속도**를 0으로 만들 뿐 이미 쌓인 **속도**는 없애지
못한다. 고도·수직속도 피드백 없이 고도 유지는 불가능하다. 앞의 v_z 적분
오류와 같은 종류다 — 변화율과 그 적분을 혼동했다.

하강 가속도 = `−g × FS_DESCENT_DELTA_US / (hover − idle)`
= `−9.81 × 60/340` = **−1.731 m/s²** (공기저항 무시, 초기 구간)

| resume 시점 | 잔류 하강속도 |
|---|---|
| 0.5초 | −0.87 m/s |
| 1.0초 | −1.73 m/s |
| 2.0초 | −3.46 m/s |

**늦게 resume할수록 쓸모가 없다.** 실무 지침: 링크가 돌아오면 즉시
resume하고, 곧바로 스로틀을 올려 고도를 회복한다. resume 자체는 "더 빨리
내려가는 것을 멈출" 뿐이다.

따라서 V6의 합격 기준은 다음으로 정정한다:
- `fs_phase`가 `FS_DESCENDING → FS_NONE`이 된다
- `base_throttle`이 `hover_est`로 복원된다
- **하강 가속도가 0 근처로 억제된다** (고도 유지가 아니라)
- 잔류 하강속도와 그 후 고도 손실을 **수치로 보고**한다

## 실행 순서

```
0-C (표시)        ─┐  벤치를 당장 막고 있음. 먼저.
0-A (SIL 수직)    ─┼─→ 1-B (호버 추정) ─→ 1-C′ (능동 프로브)
0-B (고속 캡처)   ─┘   1-A (스케일 보정)
2-A, 2-B          독립. 아무 때나.
```

엄격한 의존은 하나뿐이다: **0-A 없이 1-C′를 만들면 검증할 곳이 없다.**

1-A(스케일 보정)는 폐기된 v_z 적분의 수치적 전제조건이었다. 1-C′는 절대
속도를 쓰지 않으므로 더 이상 전제조건이 아니다. 다만 자세추정 신뢰도
판정과 프로브 차분의 기준선 정확도에 여전히 도움이 되므로 유지한다.

## 검증 원칙

- 각 항목마다 회귀 테스트를 먼저 RED로 확인한 뒤 GREEN으로 만든다.
- 핵심 가드는 변조로 판별력을 증명한다(이번 리뷰에서 이게 유일하게
  효과적이었다).
- **0-A 완료 후, 현재 코드로 1·2·3번이 SIL에서 실제로 재현되는지 먼저
  확인한다.** 재현되지 않으면 분석이 틀린 것이다.

## 이 전략이 해결하지 못하는 것

- **위치 유지는 여전히 불가능하다.** 위치 센서가 없어 바람에 흘러간다.
  "제자리 착륙"은 이 전략 이후에도 성립하지 않는다.
- 축별 가속도 오프셋(6면 캘리브레이션 필요)은 범위 밖이다.
- 기압센서를 달면 절대 고도와 수직속도를 직접 얻어 능동 프로브 없이 착지를
  판정할 수 있다(PX4·ArduPilot이 쓰는 방식). 1-C′는 하드웨어 추가 없이
  같은 문제를 푸는 대안이며, 기압센서를 나중에 달면 프로브를 제거하고
  교체할 수 있다. 이번 범위에는 넣지 않는다.

---

# 2차 감사 결과 (2026-07-28, 적대적 재검증)

Layer 0~2 완료 후 독립 감사에서 결함 6건이 나왔다. 2건은 이미 고쳤다
(`16cd3c2` stop이 대기 중 resume 미취소, `67e26e5` 지상국에서 resume 도달
불가, `a04b3d0` over-tilt 커버리지 구멍).

## R1. 프로브 딥이 절대값이라 무거운 기체에서 공중 오검출 (최우선)

**증상**: 하강 중 접지 전에 `FS_CUT_LANDED`. 최악 사례 고도 1.4029m,
하강속도 −2.2470m/s, 접지 0.353초 전.

**빈도 실측** (진입 노이즈 위상 100개씩 스윕):

| 노이즈 sd | 질량 1.0× | 질량 1.3× |
|---|---|---|
| 0.02g | 0% | 0% |
| 0.04g | 0% | 4% |
| 0.06g | 0% | 6% |
| 0.08g | 0% | 12% |

**기전**: 프로브 신호는 `dip/(hover − 1000)`에 비례한다. 질량이 늘면 호버가
올라가(1340→1442) 같은 40µs가 11.8%에서 9.05%로 약해지고, 차분이 노이즈에
묻힌다. 실패 시 프로브 응답은 0.0167g/0.0195g로 임계 0.06g보다 훨씬 낮았다.

**이건 1-B에서 고친 것과 같은 실수다.** 하강량은 호버 상대로 바꿔놓고 프로브
딥은 절대값으로 남겼다.

**검증된 수정 — 딥을 호버 대비 비율로**:

| 질량 | 호버 | 고정 40µs | 비례 11.8% |
|---|---|---|---|
| 0.7× | 1238 | 0% | 0% (28µs) |
| 1.0× | 1340 | 0% | 0% (40µs) |
| 1.3× | 1442 | **12%** | **0%** (52µs) |
| 1.6× | 1544 | **23%** | **0%** (64µs) |

`FS_PROBE_DIP_US`(절대) → `FS_PROBE_DIP_FRAC`(= 0.118, `hover_est − 1000`의
비율). 런타임 계산이므로 `static_assert` 대신 `CTRL_MARGIN` 미만으로 클램프하고
측정 가능한 하한도 둔다.

**추가 방어 — 1g 근처 veto**: 착지 확정의 **필요조건**으로 LPF된 `|accel|`이
1g±tol 안일 것을 요구한다. 지면에 정지하면 반드시 1g다. 위 실패 사례는
`accel_min=0.7148g`였으므로 이 veto가 막았다. 이건 원래 설계 결함(1g 복귀를
**충분**조건으로 쓴 것)과 다르다 — 필요조건으로만 쓴다.

## R2. 호버 추정기 오염 → 공중에서 즉시 컷

**증상**: 실제 호버 1340µs인데 1500µs 등속 상승을 4.5초 학습하면
`hover_est=1464`. 지상컷 경계가 1464−120=1344가 되어 **현재 스로틀 1340이
그보다 낮으므로 공중에서 `RC TIMEOUT -> GROUND CUT`**이 난다. 자동착륙이
아니라 즉시 컷이다.

**조건이 이국적이지 않다.** 등속 상승은 `|accel|≈1g`, 수평, 스로틀>1150을
모두 만족한다. 정상 비행 중 1.5초면 후보 시간이 찬다. 추정기는 수직속도도
고도 변화도 보지 않는다.

**수정 — `hover_est`의 두 용도를 분리한다**:
- **하강 목표**: `hover_est` 유지. 틀려도 실패 방향이 안전하다(하강한다).
- **지상컷 판정**: `hover_est` 상대 대신 **보수적 절대 하한**을 쓴다. 너무
  높은 `hover_est`가 공중 즉시컷을 만드는 경로를 끊는다. 최악은 지상에서
  컷 대신 하강을 5초 도는 것 — 불쾌하지만 추락이 아니다.

`hover_est`가 낮게 오염되면 하강이 과격해진다(−198µs). 후보 스로틀이 현재
추정치에서 크게 벗어나면 배제하는 게이트를 함께 검토한다.

## R3. `start` pending-arm 경합

`start`의 첫 분기가 `if (!safety_lock)`만 본다. arm 요청이 대기 중이면
`safety_lock`은 아직 true이므로 **중복 `start`가 already-armed로 안 걸리고
초기화 분기를 다시 실행**한다. Core1이 그 사이 잠금을 풀면 비행 중에
fault latch·스로틀 창·목표각·`hoverTracker`가 재설정된다. `hoverTracker`는
비-volatile 다중 필드 구조체라 명백한 data race다.

**수정**: 가드를 `!safety_lock || safety_arm_requested`로.

## R4. 누적 백스톱 없음

`FS_MAX_MS`는 에피소드별 5초다. `elapsed=4999ms`에 resume을 넣으면 그
에피소드의 타임아웃을 건너뛴다. 실측으로 최초 진입 후 **21.5초** 모터 on을
연장했다. 매 에피소드마다 fresh RC와 명시적 resume이 필요하므로 자동으로
일어나지는 않는다.

**수정**: 최초 진입 시각을 resume이 지우지 않는 별도 변수로 두고, 그로부터
절대 상한(예: 3×`FS_MAX_MS`)을 넘으면 resume을 거부한다.

## R5. 프로브의 누적 하강 비용

무프로브 대비 5초에 **2.9658m**(13.7%) 더 내려간다. 완료 프로브 10회,
딥 누적 1.2초. 딥 구간 내부 변위 합은 0.083m뿐인데, 각 딥이 만든 추가
하강속도가 이후에도 남아 누적된다.

**단 이건 수직 항력이 없는 SIL 결과라 과대평가다.** 실기는 항력이 있어 더
작다.

**수정 후보**: 하강 목표를 듀티 보정한다 —
`descent = hover_est − delta + dip×duty`로 두면 프로브 주기 평균 스로틀이
의도한 하강 스로틀과 같아진다. 새 동작을 추가하지 않는 한 줄 보정이다.

## 남은 해석 한계

- 실기 노이즈가 합성 1.1~7.3Hz 파형과 같은 위상·형상을 얼마나 자주 만드는지
  모른다. 위 빈도표는 이 SIL 모델 안에서의 값이다.
- R2의 오염 조건을 실기가 얼마나 자주 만족하는지 미측정.
- R3의 듀얼코어 인터리빙은 실제 ESP32-S3 스케줄에서 캡처하지 않았다.

---

# 3차 감사 결과 (2026-07-28)

2차 감사 수정(`16cd3c2`, `67e26e5`, `a04b3d0`, `4396f9a`)이 만든 새 경로를
대상으로 했다. Codex 가 콘텐츠 필터 오탐 2회·타임아웃 1회로 완주하지 못해
상당 부분을 직접 수행했다.

## 정상으로 확인된 것

| 항목 | 결과 |
|---|---|
| 누적 예산이 재시동 때 리셋되는가 | 정상. `fs_first_enter_ms` 가 `wasLocked && !safety_lock` 에서 리셋 |
| 지상국 락 순서 역전 | 없음. 중첩·간접 모두 `safety_cmd_lock → telem_lock` 한 방향 |
| 지상컷 절대 1150 이 벤치 위험을 되살렸는가 | 회귀 아님. 이전 상대 기준은 손 파지 시 `hover_est ≈ 현재 스로틀`이라 **지상컷이 사실상 안 걸렸다.** 절대 기준이 그 구멍을 메운다 |
| 딥 클램프 경계 | 상한은 도달 불가(`hover_est=1900`에서도 106µs < 149). 하한은 `hover_est ≤ 1169`에서만 걸리는데 그때도 실효 비율이 11.8% 부근이라 무해 |
| `stop` 이 대기 중 arm 요청 취소 | 정상. `requestSafetyDisarm()` 이 arm·resume 요청을 함께 지운다. 복구 경로는 `stop` → `start` |
| 1g veto 와 바운스 상호작용 | 성질 유지. V5 에서 0.25m 상공 프로브가 0.1147g 로 반응해 카운트 리셋 |
| 커버리지 (지상컷 경계 ±, 예산 상한, 딥 하한) | 4건 변조 모두 전체 테스트가 검출 |

## R6. 부드러운 지면이 능동 프로브를 무력화한다 (신규, 미수정)

**증상**: 접지했는데 착지가 확정되지 않고 백스톱 타임아웃으로 끝난다.
**접지 후 프롭이 3.9초 더 돈다.**

**측정** (V1 기반, `k_ground` × 기울임 × 노이즈 36조합):

| `k_ground` | 결과 |
|---|---|
| 10 / 20 / 40 N/m | **18/18 전부 `FS_CUT_TIMEOUT`** (접지 4.5초, 컷 8.5초) |
| 80 / 200 / 400 N/m | 전부 `FS_CUT_LANDED` |

기울임(0/5/10°)과 노이즈(0/0.04g)는 영향이 없었다. **오직 지면 강성만이
변수다.**

`k_ground = 40 N/m`은 0.4m/s 접지에서 압축 **3.7cm** — 잔디나 흙에서 흔한
값이고 기본값 80의 절반이다.

**원인은 veto 가 아니라 프로브다.** veto 를 제거해도 18/36 그대로다. 부드러운
지면은 추력을 줄이면 눌려주므로 **공중과 구분 불가능한 반응**을 낸다. 설계
문서에 "부분 지지 지면" 한계로 적어둔 것이 정량화된 것이다.

**실패 방향은 안전하다** — 백스톱이 여전히 컷한다. 그러나 접지 상태로 4초간
프롭이 도는 것은 원래 지상 즉시컷으로 막으려던 위험과 같은 종류다.

**수정하지 않았다.** 임계를 낮추면 공중 오검출이 악화되고, 상대 기준 판정
같은 대안은 실기 데이터 없이 정할 수 없다. **Stage E-4a 를 실제 착륙면에서
수행해 결정할 사안이다.**

## 벤치 절차에 반영해야 할 것

1. **E-4a 는 실제 착륙할 지면에서 해야 한다.** 딱딱한 바닥에서 잰 분포로
   잔디 착륙을 판단할 수 없다.
2. **E-4a 의 "손에 들고 공중 응답 측정"은 그대로 하면 무효다.** 손에 든
   상태도 호버 후보 조건(수평·1g·스로틀>1150)을 모두 만족하므로 `hover_est`
   가 **손 파지 스로틀**을 학습한다. 딥은 `0.118 × (hover_est − 1000)` 이므로
   1250 에서 재면 30µs, 실제 비행 1340 에서는 40µs — **25% 다른 딥으로 잰 두
   분포를 비교하게 된다.** 반드시 실제 호버로 `hover_est` 를 확정한 뒤,
   텔레메트리 `Hover_Est` 가 같은 값일 때 잰 측정만 비교한다.
3. 잔디에서 `Phase=3`(타임아웃)으로 끝나고 프롭이 약 4초 더 도는 것은 현재
   설계의 알려진 동작이다. 놀라지 말고 기록한다.

# 6차 감사 결과

5차까지는 "이 변수/이 명령이 의심스럽다"를 추적했다. 6차는 **아직 전수로 훑지
않은 두 축**을 골랐다: 상수끼리의 제약, 그리고 텔레메트리 43필드의 tick 일관성.

## R7. `FS_LAND_LPF_ALPHA`가 프로브 감도를 숨어서 결정한다

프로브는 딥 직전 `|accel|`과 딥 중 최솟값의 차분이 `FS_PROBE_RESPONSE_G`(0.06g)를
넘으면 공중으로 본다. 그런데 그 차분의 크기 자체가 LPF 상수에 달려 있다:

```
response = FS_PROBE_DIP_FRAC × (1 − exp(−FS_PROBE_DIP_MS × FS_LAND_LPF_ALPHA / 1ms))
```

PID 루프가 1kHz라 `alpha`는 ms당 값이고 `FS_PROBE_DIP_MS`도 ms이므로, 둘의 곱이
곧 "딥이 지속되는 시정수 개수"다. 현재 120 × 0.03 = **3.6τ** → 계단의 97%를 본다.

SIL 실측(V2, 고도 2~3m 정상 하강):

| `FS_LAND_LPF_ALPHA` | 공중 프로브 응답 | 임계 0.060g 대비 | SIL 실패 테스트 |
|---|---|---|---|
| **0.03 (현재)** | 0.1146g | 1.91× | 0건 |
| 0.02 | 0.1076g | 1.79× | 0건 |
| 0.01 | 0.0789g | 1.32× | **1건 (vibration)** |
| 0.005 | 0.0464g | **0.77× → 공중을 지면으로 오판** | 3건 |

`alpha=0.005`에서 연속 무반응 카운터가 **고도 3.08m에서 이미 2에 도달**한다.
해석적 경계는 `alpha > 0.0060`이다.

**이 결함의 본질은 테스트가 잘못된 방향을 가리킨다는 것이다.** `alpha`를 0.01로
낮췄을 때 실패하는 유일한 테스트는
`vibration: configured sd survives the firmware 5Hz LPF`이고, 그 테스트의 주장은
*"필터가 노이즈를 별로 안 깎는다"*이다. 노이즈를 줄이려고 `alpha`를 낮춘 사람에게
그 실패 메시지는 "이 기준을 완화하라"로 읽힌다. 프로브 감도를 지키는 테스트는
하나도 없었다.

`FS_LAND_LPF_ALPHA`는 문서상 "전부 벤치 조정 대상" 상수 중 하나다(152행).

**가드는 한 방향만 묶는다.** 추가한 `static_assert` 두 개는 alpha가 **낮아지는**
쪽(프로브 감도 상실 → 공중 컷)만 막는다. alpha를 크게 올리면(예: 0.10) 필터가
노이즈를 그대로 통과시켜 공중 반응이 아니라 **지면에서 거짓 반응**이 나고 착지
확정이 안 된다. 그 방향은 SIL V1이 잡고(alpha=0.10에서 1건 실패) 실패 방향도
안전하다(지면 타임아웃). 그래서 컴파일 타임 가드는 위험한 쪽에만 걸었다.

## R7b. 1g veto는 등속 하강에서 프로브의 두 번째 방어가 아니다

R1(4차)에서 "비례 딥과 1g veto 두 방어가 있고 둘 다 없앨 때만 12%가 재현된다"고
적었다. 그 측정은 **가속 하강**에서 한 것이다. 등속 하강에서는 성립하지 않는다.

등속 하강의 비력은 정확히 1g이므로 `pre_dip_g = 1.0`이고, 따라서

```
response = pre_dip_g − filt = 1.0 − filt = |1 − filt|
```

즉 **프로브 판정과 veto 판정이 같은 하나의 수를 서로 다른 임계로 재는 것**이 된다.
`failsafe_land.h`를 직접 구동해 확인:

| alpha | response | 프로브 판정 (>0.060) | \|1−filt\| | veto (≤0.100) | 결과 |
|---|---|---|---|---|---|
| 0.030 | 0.1149g | AIRBORNE | 0.1149 | **BLOCKS** | 착지 안 함 |
| 0.020 | 0.1076g | AIRBORNE | 0.1076 | **BLOCKS** | 착지 안 함 |
| 0.015 | 0.0988g | AIRBORNE | 0.0988 | passes | 착지 안 함 |
| 0.010 | 0.0827g | AIRBORNE | 0.0827 | passes | 착지 안 함 |
| 0.005 | 0.0533g | **ground(오판)** | 0.0533 | passes | **공중 착지 확정** |

veto 임계(0.10)가 프로브 임계(0.06)보다 **느슨**하므로, 프로브가 위험한 방향으로
틀리는 순간(response ≤ 0.06)에는 자동으로 `|1−filt| ≤ 0.06 ≤ 0.10`이 되어 veto가
반드시 통과한다. **등속 하강에서 veto는 프로브 오판을 원리적으로 절대 잡을 수
없다.**

임계를 조여도 안 된다. 지면에서도 `pre_dip ≈ 1.0`이고 응답이 0.038~0.051g이므로
"지면"과 "프로브가 실패한 공중"은 이 두 측정으로는 **구분 불가능한 같은 서명**을
낸다.

veto가 실제로 값을 하는 구간은 `|pre_dip − 1|`이 큰 경우 — 가속 하강(V2에서
기준선 0.79g), 접지 과도, 기울임 — 이다. 471행의 "추가 방어" 서술은 그 범위에서만
맞다.

**따라서 등속 하강에서 공중 모터컷을 막는 방어는 프로브 응답 여유 하나뿐이다.**
R7의 `static_assert`는 있으면 좋은 것이 아니라 **그 유일한 방어를 지키는 장치**다.

## R8. `HOVER_MIN_THROTTLE_US`가 프로브 가용성의 하한이다

`updateLandDetector`는 `base_throttle − dip < 1000`이면 `FS_PROBE_UNAVAILABLE`로
가고 그 뒤 영원히 착지를 확정하지 못한다(백스톱 컷으로만 끝난다).

이 조건을 풀면 `hover_est < 1080`이다. `hover_est`는 정의상 항상
`HOVER_MIN_THROTTLE_US`보다 크므로 현재 1150에서는 도달 불가능하다. 여유는
**70µs뿐**이고, `HOVER_MIN_THROTTLE_US`는 Stage E-0의 조정 대상이다.

제약: `HOVER_MIN_THROTTLE_US ≥ 1000 + FS_DESCENT_DELTA_US + FS_PROBE_DIP_MIN_US`
(= 1080). 가드 없었다.

## R9. 프로브 확정이 백스톱 안에 들어간다는 보장이 없었다

착지 확정 최단 시각 =
`FS_MIN_DESCEND_MS + FS_PROBE_PERIOD_MS × (FS_PROBE_CONFIRM_N − 1) + FS_PROBE_DIP_MS`
= 1000 + 400 + 120 = **1520ms** < `FS_MAX_MS`(5000).

`FS_PROBE_PERIOD_MS`를 2000으로 올리거나 `CONFIRM_N=4 / PERIOD=1500`으로 바꾸면
**착지를 절대 확정하지 못한다**. SIL이 각각 4건/5건 실패로 잡고 실패 방향도
안전하다(지면에서 타임아웃). 관계식만 코드에 없었다.

**처음 쓴 식은 틀렸다.** `PERIOD × (CONFIRM_N − 1)`로 적었더니 period=2000이
3120 < 5000으로 통과했는데 SIL은 3건 타임아웃이었다. 원인은 **접지 전에 버려지는
공중 프로브**를 세지 않은 것이다 — V1에서 첫 프로브(elapsed=1000)는 접지
(elapsed≈1087) 전이라 공중 반응을 내고 버려진다. `× CONFIRM_N`으로 고쳐 공중
프로브 1회분을 예산에 넣었고, 두 변조 모두 컴파일 타임에 잡힌다.

**이건 필요조건일 뿐 충분조건이 아니다.** 접지 시각이 런타임 값이라 접지가 늦으면
여전히 타임아웃이 날 수 있다. 그쪽은 SIL V1/V2/V4가 잡는다. 이 오류는 변조
검사(`period=2000`이 컴파일을 통과하는지)로 발견했다 — assert를 넣고 통과하는
것만 확인했다면 못 잡았을 것이다.

## R10. 지상국 `arm()`이 락 없이 무장 상태를 공개한다

`disarm()`과 `stop_streaming_only()`는 `safety_cmd_lock`을 잡고
`is_armed`/`is_streaming`을 바꾸는데 `arm()`만 아무 락도 잡지 않는다.

조종 스레드의 arm과 텔레메트리/stdin 스레드의 disarm이 겹치면 disarm의 `stop`이
먼저 나가고 arm의 `reliable_send("start")` 재전송이 나중에 도착할 수 있다. 드론은
무장되는데 지상국은 `is_armed=False`로 믿는다. RC를 안 보내므로 500ms 뒤 RC
타임아웃이 나고 그 시점엔 `hover_valid`가 없어 즉시 컷이라 피해는 프롭 0.5초
회전으로 제한되지만, **조종자가 기체에 손을 뻗는 바로 그 상황이다.**

부수적으로 `last_arm_time`이 `is_armed`보다 **나중에** 대입되어, 다른 스레드가
`is_armed=True`와 옛 `last_arm_time`을 함께 보고 1.5초 grace를 이미 지난 것으로
오판해 "시동 거부" 오보를 낼 수 있다.

## R11. `mag_reference_pending`이 코어 간에 유실될 수 있다

Core 1이 읽고(1004행) 지우는(1008행) 사이에 Core 0의 set이 끼면 그 set이 사라진다.
결과는 `angleZ`를 리셋했는데 yaw 기준 오프셋이 옛 값으로 남아 mag 융합이 기체를 옛
heading 쪽으로 τ≈4초에 걸쳐 돌리는 것이다. 확률은 명령당 1e-4 수준이고 mag는 기본
OFF다. `safetyRequestMux`로 같은 문제를 이미 푼 전례가 있으므로 같은 방식으로 맞춘다.

## R12. 하강 중 목표각 이중 writer — 실재하나 무해

1112행 주석의 "하강 중에는 매 tick 덮어쓰므로 파서에 failsafe 분기가 필요 없다"는
정상상태에서는 맞다. 인터리빙은 남는다: Core 1이 1115~1118행에서 목표를 쓰고
1165/1172행에서 읽기 전에 Core 0의 `setRcTargets`가 끼면 그 tick의 outer loop이
조종자 스틱을 쓴다.

창은 tick당 수 µs, 5초 하강 동안 기대 **0.5회**, 1회당 최대 4ms 동안 자세 약
**0.7°**. 안전 문제가 아니다. 가드가 한 줄이므로 불변식을 "거의 참"에서 "참"으로
올리는 차원에서만 넣는다. Serial 출력은 넣지 않는다 — rc가 50Hz로 들어와 하강
5초에 250회가 되고 TX 포화가 `pid_task`를 막으면 500ms 태스크 워치독이 비행 중
재부팅을 일으킨다.

## 텔레메트리 tick 일관성 — 결함 없음 (음성 결과)

43필드를 어느 코어가 언제 쓰고 소비자가 어떻게 조합하는지 전수로 확인했다.
**결정을 바꾸는 필드쌍은 없다.**

- 최대 skew는 `sendTelemetry`가 Core 0에서 WiFi 스택에 선점되는 시간이며, 계측
  임계가 30ms인 것으로 보아 그 정도까지 벌어질 수 있다.
- 프로브 진단 5필드(`Hover_Est`/`Hover_Valid`/`Probe_State`/`NoResponse`/
  `Response_G`)는 이미 `beginPacket` 전에 지역변수로 스냅샷된다.
- resume 성공 판정(`Failsafe_Phase==0` + `Hover_Est`)은 안전한 순서다 —
  `hover_est`는 하강 내내 동결되고 스냅샷이 `fs_phase` 읽기보다 **먼저** 일어난다.
- `Armed`(arg 22)와 `Failsafe_Phase`(arg 36)는 자동착륙 종료 tick에 한 패킷 동안
  엇갈릴 수 있으나, 다음 패킷(50ms)이 바로잡고 어느 조합도 위험한 동작을 만들지
  않는다.
- `MagHeading`과 `Mag_X/Y/Z`도 엇갈릴 수 있으나 BMM350 벤치 절차는 회전 중
  두 값을 교차 계산하지 않고 정지 스로틀 구간의 회귀만 한다(30ms → 3µs → 0.1°).
- 필드 수는 펌웨어 포맷 지정자 43개 = 스키마 43개로 일치.

# 7차 감사 결과

6차까지는 자동착륙 **내부**를 훑었다(상수, 명령, 상태변수, 텔레메트리). 7차는
자동착륙을 **가로지르는** 축을 골랐다: 다른 고장 경로와의 상호작용, 시간 산술,
부팅/초기화 실패 경로. 그 과정에서 넷째 축이 드러났다 — **구동과 감지의 분리**.

## R13. 믹서가 프로브 딥을 조용히 삼킨다 (이번 감사 전체에서 가장 심각)

하강 중 매 tick:

```
base_throttle = descentThrottle − (프로브 딥 중이면 dip_us : 0)
min_throttle  = max(1050, descentThrottle − CTRL_MARGIN)
max_throttle  = min(1900, descentThrottle + CTRL_MARGIN)
```

`mixAndDesaturate`는 collective를 `[minMotor − minDiff, maxMotor − maxDiff]`로
클램프한다. 자세 차동이 크면 **하한이 올라가 요청한 딥이 잘린다.**

손실 시작 조건: `|minDiff| > CTRL_MARGIN − dip_us` = 150 − 40 = **110µs**

실제 `mixAndDesaturate`를 그대로 돌린 결과(하강 1280µs, 딥 40µs):

| `\|minDiff\|` | 전달된 딥 | `mixer_scaled` |
|---|---|---|
| 110 | 40µs (100%) | 0 |
| 120 | 30µs (75%) | 0 |
| 130 | 20µs (50%) | 0 |
| 140 | 10µs (25%) | 0 |
| **150** | **0µs (0%)** | **0** |

**`|minDiff| = 150`은 설계상 도달 가능한 값이다.** `I_TERM_MAX_US`가 축당 50µs이고
`diff[0] = −pitch + roll − yaw`이므로, 적분기 3축이 각자 한계에 있고 부호가
(roll, pitch, yaw) = (−50, +50, +50)이면 정확히 −150이 된다. 적분기가 한계로
가는 것은 CG 치우침이나 모터 토크 불균형에서 정상적으로 일어난다 — 1256~1260행
주석이 실측 +16.6dps yaw 정상상태 오차를 근거로 yaw 적분을 푼 이유가 그것이다.

**그리고 이 경우 `mixer_scaled`가 0이다.** `scale`이 1.0이라 텔레메트리에 아무
표시가 없다. 조종자도 로그도 딥이 안 나갔다는 것을 알 방법이 없다.

검출기는 딥이 나갔다고 믿고 응답을 잰다. `failsafe_land.h`를 직접 구동한 결과
(등속 하강, 비력 정확히 1g):

| 전달 딥 | 응답 | 무반응 | 결과 |
|---|---|---|---|
| 100% | 0.1149g | 0 | 착지 안 함 |
| 75% | 0.0862g | 0 | 착지 안 함 |
| **50%** | 0.0575g | 2 | **공중에서 착지 확정 (elapsed 1520ms)** |
| **0%** | 0.0000g | 2 | **공중에서 착지 확정 (elapsed 1520ms)** |

1520ms는 착지 확정이 가능한 **최단 시각**이다. 하강 시작 1.5초 만에 공중에서
모터가 꺼진다. **1g veto는 막지 못한다** — 등속 하강은 비력이 정확히 1g라 veto가
통과한다(R7b).

**SIL V1~V6이 왜 못 잡았나.** 그 시나리오들은 수평에서 수평으로 하강해 적분기가
한계 근처로 가지 않는다. 지금까지의 "공중 오컷 0%"(질량 0.7~1.6×, 노이즈
0.02~0.08g)는 전부 **교란 없는 하강**에서 나온 값이다. 이 결함은 그 봉투 밖에
있다.

### 왜 이걸 6차까지 못 봤나

1~6차는 전부 **판정 로직**을 봤다. `updateLandDetector`가 옳은 추론을 하는가,
상수가 옳은가, 상태가 옳게 공유되는가. 그런데 이 결함은 판정이 아니라
**실험 자체가 수행되지 않는 것**이다. 검출기 코드는 완전히 옳다 — 딥이 일어났다는
전제가 깨졌을 뿐이다.

능동 프로브는 기체를 **구동**해서 세계를 **감지**한다. 구동과 감지가 서로 다른
모듈에 있으면(여기서는 믹서와 검출기), 둘 사이에 "구동이 실제로 일어났는가"를
확인하는 경로가 없는 한 감지는 거짓말을 할 수 있다. **능동 감지에는 구동 확인이
판정 로직만큼 중요하다.**

## R14. 안전 명령에는 순서 보호가 없다

`rc`/`rcr`는 seq 번호로 역순·중복 패킷을 버린다. `start`/`stop`/`resume`에는
그런 것이 없다.

`reliable_send`는 20ms 간격으로 5회 보내므로 한 명령이 약 100ms의 전파 구간을
차지한다. R10 수정으로 지상국의 **전송 순서**는 `safety_cmd_lock`이 보장하지만
**도착 순서**는 보장되지 않는다. `start` 사본 하나가 뒤따르는 `stop` 버스트
전체보다 늦게 도착하면(총 200ms 이상 지연) 펌웨어가 재무장한다.

결과는 R10과 같다 — 지상국은 disarmed로 믿는데 기체가 무장. RC를 안 보내므로
500ms 뒤 타임아웃이 나고, 그 시점엔 `hover_valid`가 없어 즉시 컷이라 프롭 0.5초
회전으로 제한된다.

**확률은 극단적 꼬리다.** 200ms 이상의 UDP 지연은 802.11 재전송으로 가능하지만
흔하지 않다. 다만 이건 **락으로는 고칠 수 없는 종류**다 — 펌웨어가 오래된
`start`와 새 `start`를 구분할 방법이 없기 때문이다. `rc`가 이미 쓰는 방식(단조
증가 seq, 비전진 패킷 폐기)을 안전 명령에도 적용하면 닫힌다. **수정하지 않았다** —
R13을 먼저 처리하고 벤치에서 실제 지연 분포를 본 뒤 결정한다.

## 결함 없음 (음성 결과)

**자동착륙 × 다른 고장 경로.** 하강 중 각 고장이 어떻게 끝나는지 전수 확인했다.

| 하강 중 발생 | 처리 위치 | `fs_phase` | 모터 |
|---|---|---|---|
| 두 IMU 모두 freeze / 중재 불가 | 992~993 | `CUT_ABORT` | 컷 |
| `fault_disagree` latch | 970 → 989 | `CUT_ABORT` | 컷 |
| 60° 초과 기울기 | 1061~1064 → 1190 | `CUT_ABORT` | 컷 |
| IMU 하나 freeze | 983~988 | 유지 | 남은 하나로 계속 |
| `stop` 명령 | `requestSafetyDisarm` | `CUT_ABORT` | 컷 |

전부 안전 방향이다. 유일한 흠은 over-tilt와 착지 확정이 같은 tick에 겹치면
텔레메트리가 `CUT_LANDED`로 보고하는 것인데, 모터는 어느 쪽이든 꺼지므로
진단 표기 문제일 뿐이다.

**시간 산술.** `realDt`는 부호 없는 뺄셈이라 `micros()` 71.6분 wrap에 안전하고
`[0.0002, 0.01]`로 클램프 후 공칭값 폴백이 있다. 모든 경과시간 비교가 부호 없는
뺄셈이라 `millis()` wrap에 안전하다. `hoverTracker.eligible_ms`에는 포화 가드가
있고, `fs_first_enter_ms` 누적 예산도 wrap-safe다. `PID_WDT_TIMEOUT_MS`는
`esp_task_wdt_config_t`에 실제로 연결되어 있다(1752행).

**부팅/초기화 실패 경로.** IMU start 실패·WDT init 실패·태스크 생성 실패는 모두
무한 루프로 정지하고, 태스크 생성 실패는 `safety_lock`도 세운다. 자이로 보정
실패(`calibration_ok == false`)는 1534행에서 `start`를 거부한다 — 쓰레기 bias로
무장되는 경로는 없다.

# 2026-07-29 실기 벤치가 수정한 것

전체 실측 기록은 [power_on_bench_procedure.md](../../power_on_bench_procedure.md)
의 "2026-07-29 벤치 실측 기록" 절에 있다. **이 문서의 주장 중 실기가 뒤집은
것만** 여기 적는다.

## SIL은 딱딱한 지면의 프로브 응답을 과대평가한다

이 문서 여러 곳이 "최대 지면 응답 0.0512g와 최소 공중 응답 0.0625g의 간격이
**0.011g뿐**"이라는 SIL 수치를 근거로 판정 여유를 걱정했다.

실측(프롭 ON, 무게추로 고정 = 완전 지지)은 **0.0010 ~ 0.0040 g**다. 임계
0.06g 대비 15~60배 여유다. SIL이 접지를 스프링-댐퍼(`k_ground=80 N/m`)로
모델링했는데 눌린 기체는 사실상 강체라 그 과도응답이 나오지 않는다.

**딱딱한 지면에 한해 0.011g 걱정은 SIL 아티팩트였다.** 부분 지지(잔디·흙,
R6)는 이 측정이 말해주지 않으며 여전히 열려 있다 — 오히려 이제 R6이 지면
쪽의 **유일한** 미해결 항목이다.

같은 측정이 프로브의 작동 전제를 정량 확인했다: 설계 모델
`response ≈ dip/(hover−1000)`로 자유 상태 예상이 `20/340 = 0.059 g`인데
실측이 0.001~0.004 g이므로 **지면이 93~98%를 흡수했다.**

## 가속도 스케일 재현성은 가정보다 2.4배 나쁘다

"실현 가능성 검산" 절이 보정 후 잔차를 0.1% 수준으로 잡았다. 부팅 2회 실측
편차는 IMU1 **0.24%**, IMU2 0.14%다.

**현재 설계에는 영향이 없다.** v_z 적분은 폐기됐고(설계 #3 반증), 프로브
응답은 딥 직전값과 딥 중 최솟값의 **차분**이라 일정한 스케일 오차가 상쇄된다.
0.24% = 0.0024g로 `HOVER_ACCEL_TOL_G`(0.05)와 `FS_LAND_ACCEL_TOL_G`(0.10)
어느 쪽에도 한참 못 미친다.

**차분 판정으로 간 결정을 실측이 뒷받침한다.** 절대 임계였다면 이 오차가
그대로 판정에 실렸을 것이다.

## `FS_GROUND_CUT_MAX_US`의 실제 보호 범위

R2에서 지상컷 판정을 `hover_est` 상대에서 절대 1150µs로 바꿨고, 3차 감사 S1은
"손에 들려 있어도 호버 조건을 만족한다"를 지적했다. 실기가 그것을 재현했다 —
**프롭 ON으로 무게추에 눌린 기체가 `th 1160`에서 `Hover_Valid=1`, `Hover_Est=1160`
을 만들고 RC 단절 시 자동착륙으로 갔다.**

정지한 기체는 수평 + `|accel|`=1g + 스로틀>1150을 전부 만족한다. 오히려 정지
상태가 완벽한 1g 기준이다. 따라서:

**`FS_GROUND_CUT_MAX_US=1150`이 지키는 범위는 "조종자가 1150을 넘기지 않는
동안"뿐이다.** IMU만으로는 "추력을 내며 정지"와 "호버"를 구분할 수 없고, 그걸
구분하려고 만든 것이 바로 능동 프로브다. 실제로 프로브가 옳게 판정했다
(`Phase=2`, 1.5초). 즉 시스템은 설계대로 동작했고, **막을 수 없는 것을 막는
대신 빨리 감지하는 쪽으로 설계한 것이 맞았다.**

벤치 회피책은 스로틀을 1150 이하로 유지하는 것뿐이며 절차 문서에 반영했다.

## 실기가 확인해준 것

- 자동착륙 타이밍 상수 전부 일치: `MIN_DESCEND` 1000ms, `PERIOD` **399ms**,
  `DIP` 120ms, `DESCENT_DELTA` 60µs, 착지 확정 **1.55초**(예측 1520ms)
- 4차의 딥 클램프 경고가 첫 실기 발동에서 정확히 작동
  (`hover=1160.0 applied=20`, `0.118×160=18.9→19` → 하한 20)
- 7차 R13 미발동을 수치로 확인: 모터 확산 평균 9.0µs / 최대 15µs, 손실 시작
  임계 `|minDiff|>110`의 1/7. **무게추로 자세가 안 흔들린 덕이며 실제 비행에서는
  이 값이 훨씬 커진다**
- 1g veto가 옳게 통과: 하강 중 `|accel|` 평균 1.0012g, 폭 0.0671g
- **패킷 유실 실재**: `mag 1` 5/5, `start` 2/5, `stop` 4/5 처리. 7차 R14(안전
  명령 seq 보호 없음)가 이론이 아님을 보여준다
