lightminn/ZETIN_Drone/docs/superpowers/specs/2026-08-04-magnetometer-calibration-design.md

# 지자기 캘리브레이션 재설계 — min/max 폐기, 제약 타원체 피팅 도입

작성 2026-08-04. 대상: `firmware/flight/dual_imu_cascade_pwm`, `scripts/`, `tools/`.
참고 문헌: <https://unknownpgr.com/posts/magnetometer-calibration/index.html>
(타원체 피팅 아이디어의 출처. **코드를 그대로 쓰면 안 된다** — 아래 3절 참조.)

## 1. 무엇이 문제인가 (측정으로 확인함)

현재 펌웨어는 하드아이언 **오프셋만** 보정하고, 그 오프셋을 **min/max**로 추정한다
(`stopMagCalibration()`, `offset = (max+min)/2`). 소프트아이언(축별 이득·비직교)
보정은 아예 없다(`sampleMagnetometer()`는 축마다 상수 하나만 뺀다).

### 1.1 min/max는 무보정보다 나쁠 수 있다

정답을 아는 합성 데이터(하드아이언 `b`, 소프트아이언 `A` 기지)에 실제 손회전을
모사한 커버리지(요 위주 + 틸트 산포)를 넣고 20회 반복한 결과다. 지표는 보정 후
헤딩 오차 95퍼센타일(도).

| 방법 | 정상 회전 | 요만 회전 | 노이즈 2µT | 스파이크 15개 |
|---|---|---|---|---|
| **min/max (현행)** | 17.3° | 7.0° | 15.5° | **20회 중 13회 붕괴**, 중앙값 56.5° |
| 구(sphere) 피팅 | 7.8° | 9.4° | 7.7° | 10.9° |
| 무제약 타원체(블로그) | 0.15° | 3.5°, **2회 실패** | 1.0° | **18회 실패** |
| **제약 타원체 + 이상치 제거** | **0.14°** | **0.79°** | **1.00°** | **0.13°** |

정상 회전 조건에서 min/max는 `|B|` 산포를 6.8% → **14.5%로 악화**시켰다. 중심
추정 오차는 19 µT로, 참 하드아이언 크기(15.7 µT)보다 컸다.

원인은 구조적이다. min/max는 축마다 **극값 샘플 2개**만 본다. 1500개 중 15개의
스파이크만 있어도 그 6개가 전부 스파이크로 바뀌어 캘리브레이션이 통째로 망가진다.
평균화가 전혀 없다.

### 1.2 캘리브레이션 데이터를 밖으로 꺼낼 수 없다

`magTelemX/Y/Z`는 `.ino:1308`에서만 쓰이며 그 블록의 조건이 `mag_enabled`다.
그런데 `startMagCalibration()`은 `mag_enabled = false`로 만든다. **즉 `magcal 1`
동안 텔레메트리 자기장 3필드는 마지막 값에 얼어붙는다.** 캘리브레이션 회전의
원시 샘플은 어디에도 기록되지 않고, 결과는 시리얼에 찍히는 숫자 3개가 전부다.

그래서 지금까지 캘리브레이션 품질을 **검증할 방법이 없었다.** 잔차도, 커버리지도,
피팅 실패 여부도 알 수 없다. 이것이 이번 작업에서 가장 먼저 고쳐야 할 부분이다.

### 1.3 기존 비행 로그는 캘리브 데이터로 못 쓴다

`Mag_X/Y/Z`가 남아 있는 로그 13개에 타원체를 피팅해 봤으나, 추정 중심이 로그마다
`[-19,-6,27]`, `[3,-4,20]`, `[35,-5,6]` µT 등으로 제각각이었다. 고정된 하드아이언이
아니라 **실내 철골의 공간적 자기장 변화 + 모터 간섭**이 지배한다는 뜻이다. 따라서
"현재 상수가 몇 µT 틀렸다"는 수치는 이 로그들로 주장할 수 없다. 새 캘리브 캡처가
필요하다. (1.1의 표는 합성 데이터라 이 오염과 무관하다.)

## 2. 채택할 방법

`y = A·m + b` 모델에서 회전만 시키면 측정점은 타원체를 그린다. 이를
`Aᵀ⁻¹A⁻¹`로 되돌려 구로 만든다.

1. **일반 타원체 최소자승** — 설계행렬 `D = [x², y², z², 2xy, 2xz, 2yz, 2x, 2y, 2z, 1]`.
2. **Li & Griffiths 제약** `4J − I² = 1` (`I = A+B+C`, `J = AB+BC+CA − D²−E²−F²`)을
   걸어 일반화 고유값 문제로 푼다. 이 제약이 해가 **반드시 타원체**임을 보장한다.
3. **MAD 시그마 클리핑** — 피팅 후 잔차의 중앙값절대편차 기준 3σ 밖 샘플을 버리고
   3회 재피팅.
4. 중심 `c = −M⁻¹b`, 스케일 `k = cᵀMc − J`, 화이트닝 `W = V·diag(√λ)·Vᵀ` (`M/k = VΛVᵀ`).
   보정값은 `W·(raw − c)`이며, 평균 반경을 곱해 **µT 단위를 보존**한다.

## 3. 블로그 코드를 그대로 쓰면 안 되는 이유

원문 코드에는 실사용을 막는 결함이 셋 있다. 아이디어는 옳지만 구현은 고쳐야 한다.

1. **제약이 없다.** `‖β‖ = 1`만 걸면 해가 쌍곡면으로 수렴할 수 있다. 이 드론의
   실제 로그 13개 **전부**에서 그렇게 됐고(`M`의 고유값이 음수), 합성 데이터에서도
   요만 회전 시 20회 중 2회, 스파이크가 있으면 18회 실패했다. 그러면 `sqrt(음수)`가
   되어 `NaN`이 나온다.
2. **`np.linalg.eig`를 대칭행렬에 쓴다.** 고유값 순서·부호가 보장되지 않아 `β`의
   부호가 뒤집히면 `M`이 음정부호가 된다. 완전한 구 커버리지의 이상적 합성
   데이터에서도 원문 코드는 `NaN`을 뱉었다. `eigh`를 쓰고 `trace(M)` 부호를
   정규화해야 한다.
3. **전치 오류.** 원문은 `Q = diag(√D) @ V`인데, `M = V·diag(D)·Vᵀ`이므로
   `‖Q(x−c)‖² = (x−c)ᵀ M (x−c)`를 만족하려면 `Q = diag(√D) @ V.T`여야 한다.
   `V`와 `V.T`를 바꾸면 보정 결과가 임의 회전만큼 돌아간다 — 헤딩을 뽑는
   용도에서는 치명적이다. (원문은 정규화 단계에서 `(data − c) @ Q`, 최종
   적용에서 `Q @ (x − c).T`를 써서 두 곳의 규약도 서로 다르다.)
4. 스케일링 부재로 `DᵀD`의 조건수가 나쁘다(`x²`항 ~2500 대 상수항 1). 피팅 전
   RMS 반경으로 정규화해야 한다.

## 4. 구현 범위

### 4.1 펌웨어 `dual_imu_cascade_pwm.ino`

- **보정 모델 확장.** `MAG_HARD_IRON_OFFSET_{X,Y,Z}`를 `MAG_HARD_IRON[3]`으로
  묶고, `MAG_SOFT_IRON[3][3]`을 추가한다. 기본값은 현재 오프셋 + **단위행렬**이라
  새 상수를 굽기 전까지 거동이 바뀌지 않는다. 적용식은
  `out_i = MAG_BODY_SIGN_i · Σ_j MAG_SOFT_IRON[i][j] · (raw_j − MAG_HARD_IRON_j)`.
- **캘리브 중 원시 샘플 공개.** `mag_calibrating`일 때 `sampleMagnetometer()`가
  **보정 전 raw**를 `magTelem{X,Y,Z}`에 쓴다. `mag_enabled`와 `mag_calibrating`은
  상호배타이므로(`startMagCalibration()`이 `mag_enabled=false`) 두 코어가 동시에
  쓰지 않는다.
- **텔레메트리 필드 추가.** 마지막에 `Mag_Cal_Active`(0/1)를 덧붙인다 —
  호스트가 로그에서 캘리브 구간을 명확히 골라내기 위함. 기존 관례대로 뒤에만 붙여
  구형 패킷 호환을 유지한다.
- **min/max 제거.** `stopMagCalibration()`은 더 이상 오프셋을 계산하지 않는다.
  대신 샘플 수와 축별 span을 찍고 `scripts/magcal_fit.py`를 돌리라고 안내한다.
  min/max 누적 상태(`magCalMin/Max`)는 span 보고용으로만 남긴다.

### 4.2 호스트 `scripts/magcal_fit.py` (신규)

- 입력: 비행 로그 CSV. `Mag_Cal_Active == 1` 구간을 자동 선택(`--all`로 우회).
- 2절의 방법으로 피팅.
- **커버리지 검증**: 방향 단위벡터 공분산의 고유값 비가 크면 경고, 퇴화면 거부.
  (참고로 기존 로그들은 3.7~34.5배였다.)
- **리포트**: 보정 전/후 `|B|` 산포(%), 피팅 반경 3개와 축비, 95퍼센타일
  radial residual(µT와 반경 대비 %). radial residual은 구면 피팅 오차이며,
  독립 자세 기준이 없으므로 여기서 헤딩 정확도를 추정하지 않는다.
- **출력**: 펌웨어에 붙여넣을 `MAG_HARD_IRON` / `MAG_SOFT_IRON` 상수 블록.
- **`mag_comp` 재환산 주의.** 모터 전류 보정 계수는 `.ino:1305`에서 *보정 후*
  도메인에 적용된다. 소프트아이언 행렬이 단위행렬이 아니게 되면 그 의미가 바뀐다.
  간섭은 물리적으로 raw 축의 ΔB이고 변환은 선형이므로 새 계수는 정확히
  `W·(기존 계수)`다. 스크립트가 이 환산값도 같이 출력하고, 재검증을 권고한다.

### 4.3 테스트

- `tools/test_magcal_fit.py`: 정답 기지 합성 데이터에서 `b`와 `A` 복원(허용오차
  이내), 이상치 강건성, 퇴화 커버리지 거부, 쌍곡면 입력 거부.
- `tools/native_tests/test_mag_yaw_fusion.cpp`: 단위행렬일 때 기존 거동과 동일함,
  비단위행렬일 때 `W(raw−b)`가 정확히 적용됨.

### 4.4 문서

- `docs/bmm350_yaw_bench_test.md` 1단계 절차를 새 흐름으로 갱신(기록형 날짜 결과는
  보존하고 정정 병기).
- `logs/README.md`, `docs/udp_protocol.md`, `scripts/telemetry_schema.py`에
  새 필드 반영.

## 5. 완료 조건

- 합성 정답 데이터에서 헤딩 오차 95p < 1.5°, 스파이크 75개에도 피팅 실패 0회.
- 단위행렬 기본값으로 기존 native 테스트 전부 통과(거동 불변).
- `magcal 1` 중 로그 CSV에 원시 자기장 샘플이 실제로 기록됨.
