lightminn/ZETIN_Drone/firmware/examples/BMM_TEST/BMM_TEST.ino

/*!
  * @file  CalibratedMagnedticData.ino
  * @brief Get the  Calibrated geomagnetic data at 3 axis (x, y, z), get the compass degree
  * @n "Compass Degree", the angle formed when the needle rotates counterclockwise from the current position to the true north
  * @n Experimental phenomenon: serial print the geomagnetic data of x-axis, y-axis and z-axis and the compass degree
  * @copyright   Copyright (c) 2010 DFRobot Co.Ltd (http://www.dfrobot.com)
  * @license     The MIT License (MIT)
  * @author      [GDuang](yonglei.ren@dfrobot.com)
  * @version     V1.0.0
  * @date        2024-05-06
  * @url         https://github.com/DFRobot/DFRobot_BMM350/
  */
 
// =======================================================
//   请先阅读项目 https://github.com/DFRobot/DFRobot_BMM350/tree/master/examples/calibration
//   Please read https://github.com/DFRobot/DFRobot_BMM350/tree/master/examples/calibration
//   包含使用说明、校准步骤。
//   It contains usage instructions, calibration steps.
// =======================================================

#include "DFRobot_BMM350.h"

#define SDA_PIN 16
#define SCL_PIN 17

DFRobot_BMM350_I2C bmm350(&Wire, I2C_ADDRESS);
//hard iron calibration parameters
const float hard_iron[3] = { -13.45, -28.95, 12.69 };
//soft iron calibration parameters
const float soft_iron[3][3] = {
  { 0.992, -0.006, -0.007 },
  { -0.006, 0.990, -0.004 },
  { -0.007, -0.004, 1.019 }
};

void setup() {
  Serial.begin(115200);
  while (!Serial)
    ;
  while (bmm350.begin()) {
    Serial.println("bmm350 init failed, Please try again!");
    delay(1000);
  }
  Serial.println("bmm350 init success!");

  /**
   * Set sensor operation mode
   * opMode:
   *   eBmm350SuspendMode      // suspend mode: Suspend mode is the default power mode of BMM350 after the chip is powered, Current consumption in suspend mode is minimal, 
   *                               so, this mode is useful for periods when data conversion is not needed. Read and write of all registers is possible.
   *   eBmm350NormalMode       // normal mode  Get geomagnetic data normally.
   *   eBmm350ForcedMode       // forced mode  Single measurement, the sensor restores to suspend mode when the measurement is done.
   *   eBmm350ForcedModeFast  // To reach ODR = 200Hz is only possible by using FM_ FAST.
   */
  bmm350.setOperationMode(eBmm350NormalMode);

  /**
   * Set preset mode, make it easier for users to configure sensor to get geomagnetic data (The default rate for obtaining geomagnetic data is 12.5Hz)
   * presetMode:
   *   BMM350_PRESETMODE_LOWPOWER      // Low power mode, get a fraction of data and take the mean value.
   *   BMM350_PRESETMODE_REGULAR       // Regular mode, get a number of data and take the mean value.
   *   BMM350_PRESETMODE_ENHANCED      // Enhanced mode, get a plenty of data and take the mean value.
   *   BMM350_PRESETMODE_HIGHACCURACY  // High accuracy mode, get a huge number of take and draw the mean value.
   * rate:
   *   BMM350_DATA_RATE_1_5625HZ
   *   BMM350_DATA_RATE_3_125HZ
   *   BMM350_DATA_RATE_6_25HZ
   *   BMM350_DATA_RATE_12_5HZ   (default rate)
   *   BMM350_DATA_RATE_25HZ
   *   BMM350_DATA_RATE_50HZ
   *   BMM350_DATA_RATE_100HZ
   *   BMM350_DATA_RATE_200HZ
   *   BMM350_DATA_RATE_400HZ
   */
  bmm350.setPresetMode(BMM350_PRESETMODE_HIGHACCURACY,BMM350_DATA_RATE_25HZ);

  /**
   * Enable the measurement at x-axis, y-axis and z-axis, default to be enabled, no config required, the geomagnetic data at x, y and z will be inaccurate when disabled.
   * Refer to setMeasurementXYZ() function in the .h file if you want to configure more parameters.
   */
  bmm350.setMeasurementXYZ();
}

void loop() {
  sBmm350MagData_t magData = bmm350.getGeomagneticData();

  float mag_data[3];

  // hard iron calibration
  mag_data[0] = magData.float_x + hard_iron[0];
  mag_data[1] = magData.float_y + hard_iron[1];
  mag_data[2] = magData.float_z + hard_iron[2];

  //soft iron calibration
  for (int i = 0; i < 3; i++) {
    mag_data[i] = (soft_iron[i][0] * mag_data[0]) + (soft_iron[i][1] * mag_data[1]) + (soft_iron[i][2] * mag_data[2]);
  }

  magData.x = mag_data[0];
  magData.y = mag_data[1];
  magData.z = mag_data[2];
  magData.float_x = mag_data[0];
  magData.float_y = mag_data[1];
  magData.float_z = mag_data[2];

  Serial.print("mag x = ");Serial.print(magData.x);Serial.println(" uT");
  Serial.print("mag y = ");Serial.print(magData.y);Serial.println(" uT");
  Serial.print("mag z = ");Serial.print(magData.z);Serial.println(" uT");

  // float type data
  //Serial.print("mag x = "); Serial.print(magData.float_x); Serial.println(" uT");
  //Serial.print("mag y = "); Serial.print(magData.float_y); Serial.println(" uT");
  //Serial.print("mag z = "); Serial.print(magData.float_z); Serial.println(" uT");

  float compassDegree = getCompassDegree(magData);
  Serial.print("the angle between the pointing direction and north (counterclockwise) is:");
  Serial.println(compassDegree);
  Serial.println("--------------------------------");
  delay(3000);
}
float getCompassDegree(sBmm350MagData_t magData)
{
    float compass = 0.0;
    compass = atan2(magData.x, magData.y);
    if (compass < 0) {
        compass += 2 * PI;
    }
    if (compass > 2 * PI) {
        compass -= 2 * PI;
    }
    return compass * 180 / M_PI;
}
