lightminn/ZETIN_Drone/tools/native_tests/test_failsafe_land.cpp

#include <cmath>
#include <cstdint>
#include <functional>
#include <iostream>
#include <limits>
#include <stdexcept>
#include <string>

#include "failsafe_land.h"

#ifndef FIRMWARE_FS_LAND_LPF_ALPHA
#error "FIRMWARE_FS_LAND_LPF_ALPHA must come from the firmware sketch"
#endif
#ifndef FIRMWARE_FS_PROBE_DIP_FRAC
#error "FIRMWARE_FS_PROBE_DIP_FRAC must come from the firmware sketch"
#endif
#ifndef FIRMWARE_FS_PROBE_RESPONSE_G
#error "FIRMWARE_FS_PROBE_RESPONSE_G must come from the firmware sketch"
#endif

static int g_failures = 0;

static void runCase(const std::string &name, const std::function<void()> &body) {
  try {
    body();
    std::cout << "[PASS] " << name << '\n';
  } catch (const std::exception &error) {
    std::cerr << "[FAIL] " << name << ": " << error.what() << '\n';
    g_failures++;
  }
}

#define CHECK(expr)                                                          \
  do {                                                                       \
    if (!(expr)) throw std::runtime_error(#expr);                            \
  } while (0)

static const LandProbeConfig kProbeConfig = {
    1.0f,  // lpf_alpha
    1000,  // min_descend_ms
    400,   // period_ms
    120,   // dip_ms
    30,    // sample_delay_ms
    0.06f, // response_g
    0.10f, // ground_accel_tol_g
    2,     // confirm_n
    40,    // dip_us
};

static bool probeStep(LandDetector &det, float accel_magnitude_g,
                      uint32_t elapsed_ms, int base_throttle_us = 1280) {
  return updateLandDetector(
      det, accel_magnitude_g, elapsed_ms, base_throttle_us, kProbeConfig);
}

static bool finishProbe(LandDetector &det, uint32_t start_ms,
                        float sampled_accel_g, bool delivery_valid) {
  CHECK(!probeStep(det, 1.0f, start_ms));
  CHECK(det.probe_state == FS_PROBE_DIP);
  CHECK(!probeStep(det, sampled_accel_g, start_ms + 30U));
  recordLandDetectorProbeDelivery(
      det, start_ms + 30U, delivery_valid, kProbeConfig);
  return probeStep(det, sampled_accel_g, start_ms + 120U);
}

static void leaveProbeResultState(LandDetector &det, uint32_t elapsed_ms) {
  CHECK(!probeStep(det, 1.0f, elapsed_ms));
  CHECK(det.probe_state == FS_PROBE_WAIT);
}

int main() {
  runCase("호버 후보 시간이 2초 누적된 뒤에만 유효해진다", [] {
    HoverThrottleEstimator estimator = {};
    for (uint32_t t = 0; t < 2000; t++) {
      updateHoverThrottleEstimator(
          estimator, true, 1340, t, 0.001f, 3.0f, 2000);
      CHECK(!estimator.valid);
    }
    updateHoverThrottleEstimator(
        estimator, true, 1340, 2000, 0.001f, 3.0f, 2000);
    CHECK(estimator.valid);
    CHECK(std::fabs(estimator.estimate_us - 1340.0f) < 1e-3f);
  });

  runCase("호버 유효시간은 부적합 구간을 제외하고 누적한다", [] {
    HoverThrottleEstimator estimator = {};
    for (uint32_t t = 0; t <= 1000; t++) {
      updateHoverThrottleEstimator(
          estimator, true, 1300, t, 0.001f, 3.0f, 2000);
    }
    for (uint32_t t = 1001; t <= 1500; t++) {
      updateHoverThrottleEstimator(
          estimator, false, 1700, t, 0.001f, 3.0f, 2000);
      CHECK(!estimator.valid);
    }
    for (uint32_t t = 1501; t < 2500; t++) {
      updateHoverThrottleEstimator(
          estimator, true, 1340, t, 0.001f, 3.0f, 2000);
      CHECK(!estimator.valid);
    }
    updateHoverThrottleEstimator(
        estimator, true, 1340, 2500, 0.001f, 3.0f, 2000);
    CHECK(estimator.valid);
    CHECK(estimator.estimate_us > 1310.0f);
    CHECK(estimator.estimate_us < 1340.0f);
  });

  runCase("유효 호버 추정치는 3초 시정수 LPF로 천천히 추적한다", [] {
    HoverThrottleEstimator estimator = {};
    for (uint32_t t = 0; t <= 2000; t++) {
      updateHoverThrottleEstimator(
          estimator, true, 1340, t, 0.001f, 3.0f, 2000);
    }
    CHECK(estimator.valid);
    for (uint32_t t = 2001; t <= 3000; t++) {
      updateHoverThrottleEstimator(
          estimator, true, 1400, t, 0.001f, 3.0f, 2000);
    }
    CHECK(estimator.estimate_us > 1356.0f);
    CHECK(estimator.estimate_us < 1358.0f);
  });

  runCase("하강 스로틀은 진입값에서 delta를 뺀 값이다", [] {
    CHECK(failsafeDescentThrottle(1360, 60) == 1300);
  });

  runCase("하강 스로틀은 1000 미만으로 내려가지 않는다", [] {
    CHECK(failsafeDescentThrottle(1020, 60) == 1000);
  });

  runCase("호버 비례 프로브 딥은 반올림하고 런타임 상하한을 공개한다", [] {
    bool clamped = true;
    CHECK(failsafeProbeDipUs(1340.0f, 0.118f, 20, 150, clamped) == 40);
    CHECK(!clamped);
    CHECK(failsafeProbeDipUs(1442.0f, 0.118f, 20, 150, clamped) == 52);
    CHECK(!clamped);
    CHECK(failsafeProbeDipUs(1100.0f, 0.118f, 20, 150, clamped) == 20);
    CHECK(clamped);
    CHECK(failsafeProbeDipUs(2500.0f, 0.118f, 20, 150, clamped) == 149);
    CHECK(clamped);
    CHECK(failsafeProbeDipUs(
              std::numeric_limits<float>::quiet_NaN(),
              0.118f, 20, 150, clamped) == 20);
    CHECK(clamped);
  });

  runCase("min_descend 전에는 필터만 갱신하고 프로브를 시작하지 않는다", [] {
    LandDetector det = {};
    CHECK(!probeStep(det, 1.20f, 0));
    CHECK(!probeStep(det, 0.80f, 500));
    CHECK(det.filt_init);
    CHECK(std::fabs(det.filt - 0.80f) < 1e-6f);
    CHECK(det.probe_state == FS_PROBE_WAIT);
    CHECK(!landDetectorProbeActive(det));
  });

  runCase("min_descend에서 딥을 시작하고 120ms 동안만 활성이다", [] {
    LandDetector det = {};
    CHECK(!probeStep(det, 1.0f, 999));
    CHECK(!probeStep(det, 1.0f, 1000));
    CHECK(det.probe_state == FS_PROBE_DIP);
    CHECK(det.probe_start_ms == 1000);
    CHECK(landDetectorProbeActive(det));
    CHECK(!probeStep(det, 1.0f, 1119));
    CHECK(landDetectorProbeActive(det));
    CHECK(!probeStep(det, 1.0f, 1120));
    CHECK(det.probe_state == FS_PROBE_EVALUATE);
    CHECK(!landDetectorProbeActive(det));
    CHECK(det.no_response_count == 1);
  });

  runCase("딥 첫 30ms의 과도는 반응 표본에서 제외한다", [] {
    LandDetector det = {};
    CHECK(!probeStep(det, 1.0f, 1000));
    CHECK(!probeStep(det, 0.70f, 1029));
    CHECK(!probeStep(det, 1.0f, 1030));
    CHECK(!probeStep(det, 1.0f, 1120));
    CHECK(std::fabs(det.last_response_g) < 1e-6f);
    CHECK(det.no_response_count == 1);
  });

  runCase("딥 중 0.06g 초과 하락은 공중 반응으로 판정한다", [] {
    LandDetector det = {};
    CHECK(!probeStep(det, 1.0f, 1000));
    CHECK(!probeStep(det, 0.88f, 1030));
    CHECK(!probeStep(det, 0.88f, 1120));
    CHECK(det.last_response_g > 0.06f);
    CHECK(det.no_response_count == 0);
  });

  runCase("연속 두 번 무반응이어야 착지를 확정한다", [] {
    LandDetector det = {};
    CHECK(!probeStep(det, 1.0f, 1000));
    CHECK(!probeStep(det, 1.0f, 1120));
    CHECK(det.no_response_count == 1);
    CHECK(!probeStep(det, 1.0f, 1121));
    CHECK(det.probe_state == FS_PROBE_WAIT);
    CHECK(!probeStep(det, 1.0f, 1400));
    CHECK(probeStep(det, 1.0f, 1520));
    CHECK(det.no_response_count == 2);
  });

  runCase("두 무반응 사이의 공중 반응은 연속 카운트를 지운다", [] {
    LandDetector det = {};
    CHECK(!probeStep(det, 1.0f, 1000));
    CHECK(!probeStep(det, 1.0f, 1120));
    CHECK(det.no_response_count == 1);
    CHECK(!probeStep(det, 1.0f, 1121));
    CHECK(!probeStep(det, 1.0f, 1400));
    CHECK(!probeStep(det, 0.80f, 1430));
    CHECK(!probeStep(det, 0.80f, 1520));
    CHECK(det.no_response_count == 0);
    CHECK(!probeStep(det, 1.0f, 1521));
    CHECK(!probeStep(det, 1.0f, 1800));
    CHECK(!probeStep(det, 1.0f, 1920));
    CHECK(det.no_response_count == 1);
  });

  runCase("전달되지 않은 프로브는 무반응 카운트를 올리거나 내리지 않는다", [] {
    LandDetector det = {};
    det.no_response_count = 1;

    CHECK(!finishProbe(det, 1000, 1.0f, false));
    CHECK(det.probe_state == FS_PROBE_BLOCKED);
    CHECK(det.no_response_count == 1);
  });

  runCase("막힌 프로브 다음 정상 프로브는 다시 정상적으로 계수된다", [] {
    LandDetector det = {};
    CHECK(!finishProbe(det, 1000, 1.0f, false));
    CHECK(det.probe_state == FS_PROBE_BLOCKED);
    CHECK(det.no_response_count == 0);
    leaveProbeResultState(det, 1121);

    CHECK(!finishProbe(det, 1400, 1.0f, true));
    CHECK(det.probe_state == FS_PROBE_EVALUATE);
    CHECK(det.no_response_count == 1);
  });

  runCase("막힌 프로브만 반복되면 착지를 확정하지 않는다", [] {
    LandDetector det = {};
    for (uint32_t start_ms : {1000U, 1400U, 1800U, 2200U}) {
      CHECK(!finishProbe(det, start_ms, 1.0f, false));
      CHECK(det.probe_state == FS_PROBE_BLOCKED);
      CHECK(det.no_response_count == 0);
      leaveProbeResultState(det, start_ms + 121U);
    }
  });

  runCase("공중 반응이 지운 카운트는 뒤의 막힌 프로브가 바꾸지 않는다", [] {
    LandDetector det = {};
    det.no_response_count = 1;

    CHECK(!finishProbe(det, 1000, 0.80f, true));
    CHECK(det.probe_state == FS_PROBE_EVALUATE);
    CHECK(det.no_response_count == 0);
    leaveProbeResultState(det, 1121);

    CHECK(!finishProbe(det, 1400, 1.0f, false));
    CHECK(det.probe_state == FS_PROBE_BLOCKED);
    CHECK(det.no_response_count == 0);
  });

  runCase("판정은 절대 1g가 아니라 딥 직전 대비 차분이다", [] {
    LandDetector det = {};
    CHECK(!probeStep(det, 0.90f, 1000));
    CHECK(!probeStep(det, 0.90f, 1030));
    CHECK(!probeStep(det, 0.90f, 1120));
    CHECK(std::fabs(det.last_response_g) < 1e-6f);
    CHECK(det.no_response_count == 1);
  });

  runCase("1g에서 먼 연속 무반응은 착지의 필요조건을 충족하지 않는다", [] {
    LandDetector det = {};
    CHECK(!probeStep(det, 0.80f, 1000));
    CHECK(!probeStep(det, 0.80f, 1120));
    CHECK(det.no_response_count == 1);
    CHECK(!probeStep(det, 0.80f, 1121));
    CHECK(!probeStep(det, 0.80f, 1400));
    CHECK(!probeStep(det, 0.80f, 1520));
    CHECK(det.no_response_count == 2);

    // 1g 복귀만으로 착지를 선언하는 폐기된 충분조건이 아니다. 프로브 연속
    // 무반응이 여전히 주 판별이고, 1g 근처는 착지 확정의 필요조건일 뿐이다.
    CHECK(!probeStep(det, 1.0f, 1521));
    CHECK(!probeStep(det, 1.0f, 1800));
    CHECK(probeStep(det, 1.0f, 1920));
  });

  runCase("딥이 1000us 아래로 가면 프로브 불가로 남고 착지하지 않는다", [] {
    LandDetector det = {};
    for (uint32_t t = 0; t <= 5000; t += 10) {
      CHECK(!probeStep(det, 1.0f, t, 1030));
    }
    CHECK(det.probe_state == FS_PROBE_UNAVAILABLE);
    CHECK(!landDetectorProbeActive(det));
    CHECK(det.no_response_count == 0);
  });

  runCase("LPF는 첫 샘플을 대입하고 이후 alpha로 갱신한다", [] {
    LandDetector det = {};
    const LandProbeConfig config = {
        0.25f, 1000, 400, 120, 30, 0.06f, 0.10f, 2, 40};
    CHECK(!updateLandDetector(det, 1.20f, 0, 1280, config));
    CHECK(det.filt_init);
    CHECK(std::fabs(det.filt - 1.20f) < 1e-6f);
    CHECK(!updateLandDetector(det, 0.80f, 10, 1280, config));
    CHECK(std::fabs(det.filt - 1.10f) < 1e-6f);
  });

  runCase("펌웨어 LPF 설정은 공중 프로브 응답 여유를 보존한다", [] {
    const auto run_first_probe = [](const LandProbeConfig &config) {
      LandDetector det = {};
      const uint32_t end_ms = config.min_descend_ms + config.dip_ms;
      for (uint32_t elapsed_ms = 0; elapsed_ms <= end_ms; elapsed_ms++) {
        const float accel_magnitude_g =
            landDetectorProbeActive(det)
                ? 1.0f - FIRMWARE_FS_PROBE_DIP_FRAC
                : 1.0f;
        CHECK(!updateLandDetector(
            det, accel_magnitude_g, elapsed_ms, 1280, config));
      }
      CHECK(det.probe_state == FS_PROBE_EVALUATE);
      return det;
    };

    LandProbeConfig config = {
        FIRMWARE_FS_LAND_LPF_ALPHA,
        1000,
        400,
        120,
        30,
        FIRMWARE_FS_PROBE_RESPONSE_G,
        0.10f,
        2,
        40,
    };
    const LandDetector firmware_det = run_first_probe(config);
    CHECK(firmware_det.last_response_g > 1.5f * config.response_g);
    CHECK(firmware_det.no_response_count == 0);

    // 진짜 불변식은 "alpha 를 낮추면 프로브 감도도 같이 낮아진다"이지
    // "특정 alpha 에서 임계 아래로 떨어진다"가 아니다. 후자는 임계를 바꾸면
    // (2026-08-01: 0.06 -> 0.03) 의미가 흔들린다. 단조성으로 고정한다.
    config.lpf_alpha = 0.005f;
    const LandDetector low_alpha_det = run_first_probe(config);
    CHECK(low_alpha_det.last_response_g < 0.5f * firmware_det.last_response_g);

    // 임계 아래로 떨어지는 분기도 계속 덮는다. 응답은 대략
    // dip_frac*(1-exp(-dip_ms*alpha)) 이므로 alpha 를 더 낮추면 도달한다.
    config.lpf_alpha = 0.002f;
    const LandDetector tiny_alpha_det = run_first_probe(config);
    CHECK(tiny_alpha_det.last_response_g < config.response_g);
    CHECK(tiny_alpha_det.no_response_count == 1);
  });

  runCase("failsafeStep: 착지가 timeout보다 우선한다", [] {
    CHECK(failsafeStep(true, 9999, 5000) == FS_CUT_LANDED);
  });

  runCase("failsafeStep: 백스톱 시간이 지나면 종료한다", [] {
    CHECK(failsafeStep(false, 5000, 5000) == FS_CUT_TIMEOUT);
    CHECK(failsafeStep(false, 4999, 5000) == FS_DESCENDING);
  });

  if (g_failures != 0) {
    std::cerr << g_failures << " failsafe-land case(s) failed\n";
    return 1;
  }
  std::cout << "23/23 failsafe-land cases passed\n";
  return 0;
}
