lightminn/ZETIN_Drone/(commit log)

2025-07-09 motor code add
2025-07-09 feat: Add motor control module
2025-07-09 feat: Add sensor implementation and update configs
2025-07-09 motor update
2025-07-09 feat: Update sensor data processing
2025-07-09 feat: Update sensor.h
2025-07-10 feat: Enable sensor.cpp for testing without physical sensor
2025-07-10 fix: Resolve build error by using std::clamp and setting C++17 standard
2025-07-10 fix: Replace std::clamp with custom_clamp and remove C++17 build flag
2025-07-10 refactor: Separate sensor logic from main loop in sensor.cpp
2025-07-10 feat: Integrate sensor logic into connect.cpp
2025-07-10 feat: Add main application logic and update sensor/connection handling
2025-07-23 cancel QP motor control system development
2025-07-23 feat: Update sensor, main, and connect source files
2025-11-05 feat: Add TCP test client and DSHOT test code
    - Add TCP test client script (`test/tcp_test.py`) to replace the deleted UDP client.
    - Add DSHOT motor test code (`DSHOT_TEST`, `DSHOT_TEST_IMU`, `DSHOT_TEST_PERCENT`).
    - Add empty `pwm_RGB.cpp` file.
    - Update WiFi credentials in `src/connect.cpp`.
    - Update VSCode settings and add a comment in `src/sensor.cpp`.
2025-11-09 refactor: Restore motor control logic and adjust access level
    - Uncomment motor control algorithm in `src/motor.cpp` to re-enable it.
    - Move `voltage` array in `lib/motor.h` to public for external access.
    - Add new test directories `MOTOR_ALGO_TEST` and `ZETIN_Drone_Standalone_Test` to tracking.
2025-11-18 refactor: Adjust DSHOT motor control parameters and settings
    - Update DSHOT_TEST and DSHOT_TEST_IMU for motor control parameter adjustments.
    - Modify ZETIN_Drone_Standalone_Test for DSHOT timing.
    - Clean up VSCode settings by removing msvcBatchPath.
2025-11-30 add pid test
2026-02-07 WIP: Initial commit before implementing UDP control
    [drone_log_20260207_213052.csv, drone_log_20260207_213229.csv, drone_log_20260207_213303.csv, flight_log_214049.csv, flight_log_214234.csv, flight_log_214335.csv, flight_log_214455.csv, flight_log_215501.csv]
2026-02-07 refactor: Reorganized project directory structure
    [drone_log_20260207_213052.csv, drone_log_20260207_213229.csv, drone_log_20260207_213303.csv, flight_log_214049.csv, flight_log_214234.csv, flight_log_214335.csv, flight_log_214455.csv, flight_log_215501.csv]
2026-02-07 docs: 각 디렉토리에 한국어 README.md 추가 및 프로젝트 루트 README 생성
2026-02-11 add kalman test
    [flight_log_201614.csv, flight_log_2026-02-11_160848.csv, flight_log_2026-02-11_161226.csv, flight_log_2026-02-11_161315.csv, flight_log_2026-02-11_161335.csv, flight_log_2026-02-11_161630.csv, flight_log_2026-02-11_165025.csv, flight_log_2026-02-11_165103.csv]
2026-02-11 fix kalman
    [flight_log_2026-02-11_174108.csv, flight_log_2026-02-11_174210.csv, flight_log_2026-02-11_175125.csv]
2026-02-21 로그 데이터 업로드 제외
2026-02-25 PCB 1.5.2 test code upload
2026-07-23 fix(flight): correct roll/pitch gyro body signs
    The gyro sensor-to-body transform negated the validated accel rotation, inverting roll and pitch rates. Match the accel transform so the complementary estimator and rate loop use physical body rates.
    Leave bodyGz unchanged because yaw was separately bench-verified and requires its own re-verification. Add physics-based roll/pitch ramp regression coverage.
    Yaw and the full controller must be re-verified on the bench before flight.
    [dual_imu_cascade_pwm.ino, test_sil_attitude.cpp]
2026-07-24 feat(flight): add BMM350 magnetometer yaw-drift correction (default off)
    Relative heading-hold via complementary fusion isolated to the yaw (angleZ) channel: 50Hz core-0 BMM350 read, hard-iron cal (magcal), tilt-compensated heading, slow (K_MAG, tau~4s) pull of angleZ toward mag heading. Runtime-gated by 'mag <0|1>', default OFF -> control path byte-identical to the validated hover build.
    Adds mag_yaw_fusion.h, MagHeading telemetry (field 31, append-only), native SIL (convergence/drift/tilt/wrap, discriminating), and docs (design spec + HW bench-test procedure). Hardware calibration/orientation/interference remain for the bench test.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
    [Arduino.h, DFRobot_BMM350.h, dual_imu_cascade_pwm.ino, test_control_math.cpp, test_mag_yaw_fusion.cpp]
2026-07-26 feat(flight): BMM350 motor-current yaw interference comp + hardening
    - XYZ-domain throttle compensation: subtract per-axis body-frame delta-B
    (mag_comp_x/y/z, uT/us) from raw mag before tilt-comp heading; cancels
    motor-current interference (bench: heading throttle-slope +3.64 -> +0.02
    deg/100us). Runtime-tunable via `magc x y z`; bench-characterized defaults
    baked in (log 023805 fit, 024330 verify).
    - Telemetry: append raw Mag_X/Y/Z (uT, fields 32-34); schema/parser stay
    backward-compatible with 31-field packets.
    - Code-review fixes (xhigh): arm-path angleZ/reference store ordering,
    `mag 1` armed-init guard, yaw outer-loop error wrap, signed cross-core
    mag freshness.
    - Tests: n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
    [dual_imu_cascade_pwm.ino, test_control_math.cpp, test_mag_yaw_fusion.cpp]
2026-07-26 fix(scripts): correct DualSense axis/button map; trigger-only throttle
    Measured the pad's real layout with new gamepad_probe.py (a0=LX a1=LY
    a2=L2 a3=RX a4=RY a5=R2; X=b0, L1=b4, R1=b5). Prior mapping put yaw on the
    L2 axis and L2 on the right-stick axis, causing erratic control. Fixes:
    yaw a2->a3, L2 a4->a2, R1/L1 b10/b9->b5/b4. Throttle is now trigger-only
    (R2/L2 hold = continuous ramp); removed the right-stick throttle mapping
    whose rest-drift made throttle self-decrease. Adds gamepad_probe.py.
2026-07-26 diag: esc_config_throttle single-pin PWM for BLHeli TX programming
    Standalone sketch (direct LEDC, GPIO7, live 1000-2000us serial-driven PWM)
    used to reverse an EMAX BLHeli 30A ESC via throttle-stick programming.
    [esc_config_throttle.ino]
2026-07-26 docs: reconcile BMM350 yaw-fusion docs with shipped state
    - bmm350_yaw_bench_test.md: record steps 1-3 pass, step-4 interference
    finding (+13° hover, corr 0.80) and its raw-XYZ-domain magc mitigation
    (+3.64→+0.02°/100µs), baked coefficients, battery caveat; add magc /
    Mag_X/Y/Z to the command/telemetry summary.
    - udp_protocol.md: CSV column count 32→35 (Mag XYZ telemetry).
    - project_overview.md: note optional BMM350 mag yaw correction + throttle
    interference comp.
2026-07-26 docs(firmware): fix Ki-tuning comment commit hash (e6d0908 -> 735f77d)
    The rate-loop Ki 0.005->0.05 change was made in 735f77d, not e6d0908
    (which is the SIL harness commit). Verified via git log -S.
    [dual_imu_cascade_pwm.ino]
2026-07-26 docs: ground-station link requirements + RC-timeout root cause
    2026-07-27 비행에서 무장 후 1.8~9.9초 만에 Fault_RC로 정지하는 현상이
    연발했다. 조사 결과 펌웨어가 아니라 지상국 무선 링크가 원인이었다.
    근본 원인: DualSense를 USB에서 뽑고 블루투스로 연결한 것. 이 노트북은
    WiFi와 BT가 같은 Intel AX211(CNVi)이라 2.4GHz 무선부와 안테나를 공유하며,
    coexistence 중재기가 시간을 쪼개 쓴다. 전파 간섭이 아니라 하드웨어 점유
    경합이므로 드론 AP 채널을 바꿔도 소용없다.
    상관관계는 예외가 없다 — 패드 USB 연결 상태의 무장 구간 8개는 전부
    정확히 20.0~2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
2026-07-26 scripts: enable mag fusion on arm, before the start command
    arm()이 start 직전에 `mag 1`을 보내 BMM350 yaw 융합을 켠다. 펌웨어가
    armed 상태에서는 최초 mag init을 거부하므로(1497d74의 armed-init guard),
    아직 disarmed인 이 시점에 보내야 부팅 후 첫 arm에서도 init이 통과한다.
    heading-hold(`yaw 1`)는 켜지 않는다. 융합은 yaw 추정 드리프트만 잡고,
    바깥 yaw 각도 루프는 꺼진 상태를 유지한다.
2026-07-26 docs: yaw rate-command + auto heading-hold design spec
    yaw 스틱을 절대 각도 명령에서 각속도 명령으로 바꾸고, 스틱을 놓으면 그
    자리의 heading을 자동으로 잠그는 설계. 조사에서 확인된 문제 3개를 한 번에
    닫는다.
    문제 1 — yaw 스틱이 아예 안 먹는다. arm()이 매번 `yaw 0`을 보내 바깥 각도
    루프가 실행되지 않는다. 2026-07-27 무장 구간 21개 전부에서 TgtRate_Yaw ≡ 0.
    문제 2 — 기수가 계속 돈다. yaw-hold가 꺼져 있으면 펌웨어가 iTermYaw를 강제로
    0으로 묶고 Kd도 0이라 yaw 안쪽 루프가 P 단독이다. 감쇠는 정상 동작하지만
    (corr(Gyro_Z, yaw 모터차동) = -1.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
2026-07-26 docs: gate yaw-hold override to disarmed, make settle threshold bench-tunable
    리뷰 결정 2건 반영.
    `yaw 1`을 무장 중 거부한다(magcal 1과 동일 게이트). 비행 중 임의로 켜면
    PC/드론 setpoint desync 슬램 조건이 되살아나기 때문이다. `yaw 0`은 언제나
    수락한다 — 안전한 방향으로 빠져나가는 길은 막지 않는다.
    이 결정이 오버라이드 수명과 충돌해서 함께 조정했다. bench_yaw_test.py는
    start 뒤에 yaw 1을 보내므로 무장 게이트만 넣으면 그대로 깨진다. 그래서
    오버라이드를 start가 아니라 **무장 해제 엣지**에서 해제하도록 바꿨다.
    safety_lock 분기는 잠긴 동안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
2026-07-26 docs: yaw rate-command implementation plan (8 tasks)
    스펙 2026-07-27-yaw-rate-command-design.md의 구현 계획.
    Task 1 yaw_command.h 순수 헬퍼 + 단위 테스트 8종 (mag_yaw_fusion.h 패턴)
    Task 2 rcr 파서와 디스패치 + 파서 테스트 7종
    Task 3 pid_task 배선, yaw_enabled → yaw_hold_override 개명
    Task 4 yaw 적분 해금 + 판별형 플랜트 회귀 테스트
    Task 5 yaw 1 무장 게이트 + 무장 해제 엣지 해제
    Task 6 Yaw_Hold 텔레메트리 34 → 35필드
    Task 7 지상국 전환 (target_yaw 삭제, bench_yaw_test 순서)
    Task 8 문서 5종
    모드 판정과 setpoint 슬레이빙을 순수 함수로 헤더에 분리해 플랜트 없이
    단위 테스트한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
2026-07-26 docs: fix Task 1 wrapper instruction to drop mutation machinery
    계획의 Task 1 Step 5가 "test_mag_yaw_fusion.py를 세 값만 바꿔 미러링"이라고
    지시했는데, 그 파일 전문을 확인하지 않고 쓴 잘못된 지시였다. 해당 파일에는
    mag 전용 뮤테이션 테스트 기계장치가 들어 있다.
    그대로 미러링하면 실질적 해가 있다. 뮤테이션 블록은 mag_yaw_fusion.h를
    변조하므로, BMM350_SIL_MUTATION=inverted로 실행하면 mag 헤더를 변조한 뒤
    mag과 무관한 yaw_command 테스트를 컴파일해 통과시킨다. 뮤테이션을 잡은
    것처럼 보이지만 실제로는 아무것도 검증하지 않아 mag 쪽 뮤테이션 검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
2026-07-26 feat(flight): add pure yaw outer-loop helpers with unit tests
2026-07-26 feat(flight): add rcr yaw-rate command parser
2026-07-26 docs: scope the yaw_enabled rename to the cascade sketch and its tests
    계획의 Task 3 Step 1이 'grep -n yaw_enabled 로 전수 확인'이라고만 해서 범위가
    모호했다. 실제로는 보관 펌웨어 3종과 flix 펌웨어에도 같은 이름의 독립 변수가
    있어 전역 rename은 틀린다. 대상 4개 파일 10곳을 표로 못박고, 건드리면 안 되는
    경로와 범위 한정 grep 확인 명령을 명시했다.
2026-07-26 feat(flight): wire yaw rate command with auto heading hold
2026-07-26 docs: SIL cannot close the yaw loop; assert integrator liveness instead
    계획의 Task 4 테스트가 SIL 폐루프 yaw 정상상태 각속도로 단언하도록 돼 있었는데,
    그 위에서는 통과할 수 없다. SIL의 yaw 반작용 토크 부호가 미해결 항목이기
    때문이다 — test_sil_attitude.cpp:1035가 'convention-dependent'라고 명시하고,
    기존 S5도 그래서 runReport로만 남기며, power_on_bench_procedure.md:175에
    'SIL S5는 CW=+ 관례에서 yaw가 발산했다(리포트만)'로 기록돼 있다.
    실행에서 P-only와 Ki=0.05가 모두 651dps로 발산해 이 기록과 일치했다.
    통과시키려 플랜트 부호를 고치는 선택지는 버렸다.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
2026-07-26 docs: make the S6 yaw-integrator assertion actually discriminating
    초안 S6는 'max|iTermYaw| > 0'만 단언해서 판별력이 없었다. 해금을 되돌린
    사본으로 실측했더니 그대로 통과했다.
    원인은 실행 초반이다. 기체가 정지 상태라 hold가 true이고, 그 구간에서는
    해금 전 코드도 적분한다. 그래서 전체 최대값은 해금 여부와 무관하게 0보다
    크다. 가려야 하는 것은 'hold가 아닌 구간에서도 쌓이는가'였다.
    Sample에 yaw_hold를 기록하고, hold가 아닌 샘플로 한정해 최대값을 본다.
    rate 모드 샘플이 100개 이상 존재하는지도 함께 단언해 시나리오가 실제로
    rate 구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
2026-07-26 fix(flight): let the yaw rate integrator run in both yaw modes
    [dual_imu_cascade_pwm.ino, test_sil_attitude.cpp]
2026-07-26 docs: clear the yaw-hold override on ALL three lock paths
    Task 5 Step 4가 주 safety_lock 블록 한 곳에만 엣지 해제를 넣게 돼 있었다.
    pid_task는 wasLocked를 세 곳에서 세운다(733 IMU 전멸, 816 주 블록, 901 late
    lock). IMU 전멸이나 late lock으로 무장 해제되면 오버라이드가 안 지워지고,
    다음 tick에 주 블록이 !wasLocked를 봐도 이미 true라 엣지가 발동하지 않는다.
    결과적으로 오버라이드가 다음 비행까지 살아남아 '비행 1회 opt-in' 보장이 깨진다.
    세 곳에 같은 줄을 흩어 놓으면 누락이 반복되므로 enterLockedState() 헬퍼로
    묶고 세 지점 모두 그것만 호출하게 했다.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
2026-07-26 feat(flight): gate yaw-hold override to disarmed, clear on disarm edge
2026-07-26 feat(telemetry): append Yaw_Hold mode field
2026-07-26 feat(scripts): send yaw as rate via rcr, drop target_yaw state
    bench_yaw_test.py는 yaw 1이 두 곳에 있어 둘 다 start 앞으로 옮겼다. 페이즈
    루프를 빠뜨리면 측정 중 disarm됐다 복구되는 경우 무장 해제 엣지에서 오버라이드가
    지워진 뒤 재무장하고, 그 다음 yaw 1이 거부되어 남은 테스트 내내 오버라이드 없이
    돈다. 그러면 비틀림에 복원 토크가 안 나와 yaw 부호 판정이 무의미해진다.
    계획에도 두 곳임을 명시했다.
2026-07-26 docs: yaw rate command, Yaw_Hold field, bench steps
    udp_protocol에 rcr과 yaw <0|1>의 새 의미(무장 중 yaw 1 거부, 무장 해제 엣지
    자동 해제)를 적고 텔레메트리를 35필드/36열로 갱신했다. rc는 벤치 도구 호환용
    지원 인터페이스로 남는다고 명시했다.
    power_on_bench_procedure의 C-3을 새 절차로 다시 썼다 — yaw 1을 start보다
    먼저 보내기, 스틱 명령 회전 확인, 놓을 때 Yaw_Hold=1과 heading 유지 확인,
    바운스백 유무로 YAW_HOLD_SETTLE_DPS를 조정하는 기준. Stage D에 yaw 적분
    해금 후 진동 관찰을 추가했다. SIL S5/S6b가 폐루프 yaw를 검증하지 못하므로
    자동 잠금과 지속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
2026-07-27 docs: failsafe auto-land design spec
    RC 링크 두절 시 즉시 모터 컷 대신 수평 유지하며 하강·착륙하는 설계.
    물리적 제약이 설계를 규정한다. 고도 센서가 없어 하강은 개루프이고 고도로
    착지를 감지할 수 없다. 위치 센서가 없어 '제자리 착륙'은 불가능하고, 만들 수
    있는 것은 '수평 자세 유지 하강'이며 착지 지점은 바람이 결정한다.
    적용은 RC 타임아웃 한 갈래뿐이다. IMU 전멸은 자세 추정 자체가 무효라
    자동착륙이 곧 fly-away이고, 과도 기울기는 이미 뒤집히는 중이라 모터를 돌리면
    지면으로 박는 방향이다. 둘 다 즉시 컷을 유지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
2026-07-27 docs: move trim to the firmware so auto-land does not drift
    사용자가 잡은 결함. 트림이 지상국에만 있어서 자동착륙 설계가 성립하지 않았다.
    control_dualsense.py가 trim_roll/trim_pitch를 전역에 들고 있다가 송신 전에
    스틱값과 합산해 보낸다(357-358줄). 펌웨어는 트림의 존재를 모르고 합산된 각도만
    받는다.
    트림이 필요하다는 것은 추정기의 0도가 진짜 수평이 아니라는 뜻이다(가속도계
    바이어스, IMU 장착 각도). 그래서 자동착륙에서 targetAngle=0을 명령하면 트림을
    넣기 전의 흐름이 그대로 재현된다. 수평 가속도는 g·tan(θ)이고 이동은 시간의
    제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
2026-07-27 docs: close five gaps found re-reading the firmware and ground station
    스펙을 현재 코드에 대고 재검증했다. 실제 결함 5건. 두 건은 심각하다.
    1) Serial 출력 폭주 → 비행 중 워치독 재부팅 (심각)
    현재 RC 타임아웃 블록은 safety_lock=true가 되면서 !safety_lock 가드 덕에 한 번만
    실행된다. 그 설정을 제거하면 하강 내내 rcTimedOut이 참이라 1kHz로 재실행되고
    Serial.println이 초당 1000번 나간다. 115200 baud는 약 11.5KB/s인데 20바이트
    ×1000 = 20KB/s라 TX 버퍼가 포화되고, Serial.println이 블로킹되면 pid_task가
    멈춰 500ms esp_task_wdt가 panic 재부팅을 일으킨다. 진입 블록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
2026-07-27 docs: failsafe auto-land implementation plan (7 tasks)
    스펙 2026-07-27-failsafe-autoland-design.md의 구현 계획.
    Task 1 failsafe_land.h 순수 헬퍼 + 단위 10종 (yaw_command.h 패턴)
    Task 2 trim 명령 + 목표각 합성
    Task 3 자동착륙 상태기계 배선 (진입·하강·종료)
    Task 4 중단 경로 (IMU 전멸 · 과도 기울기, 두 곳)
    Task 5 텔레메트리 35 → 38필드
    Task 6 지상국 (트림 전송, stop 경로 2곳 제거)
    Task 7 문서 6종 + 벤치 Stage E
    착지 감지와 상태 전이를 순수 함수로 분리해 플랜트 없이 단위 테스트한다.
    SIL은 수직 동역학이 없어 이 기능을 검증하지 못하므로, 단위 테스트의 판별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
2026-07-27 feat(flight): add pure failsafe landing-detector helpers
    [test_failsafe_land.cpp]
2026-07-27 docs: assert the failsafe entry logs exactly once
    Task 3의 가드 제거를 기존 테스트가 간접적으로만 잡았다. fs_phase 가드를
    없앤 사본으로 확인했더니 '종료 후 재시동 없이 못 남'이 FAIL했는데, 이는
    fs_enter_ms가 매 tick 재기록돼 elapsed가 FS_MAX_MS에 도달하지 못하기
    때문이다. 종료가 안 되는 것은 잡히지만 Serial 폭주 자체는 안 잡힌다.
    이 태스크에서 가장 위험한 실패 모드가 정확히 그 폭주다 — 1kHz 로그가
    115200 baud TX 버퍼를 포화시키고 pid_task가 블로킹되면 500ms 워치독이
    비행 중 재부팅을 일으킨다.
    shim이 arduino_fake::serial_output에 출력을 캡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
2026-07-27 feat(flight): auto-land on RC timeout instead of cutting motors
2026-07-27 feat(flight): abort auto-land on IMU loss or over-tilt
2026-07-27 feat(telemetry): append Failsafe_Phase and trim fields
    [dual_imu_cascade_pwm.ino]
2026-07-27 docs: gamepad disconnect also triggers auto-land
    패드가 뽑혀도 WiFi 링크는 멀쩡하다. 사라진 것은 조종 입력 수단뿐이고 이는
    Fault_RC와 위험 구조가 같다 — 조종자가 기체를 조종할 수 없는 상태. 자동착륙을
    만든 이유가 정확히 그 상황에서 떨어뜨리지 않는 것이므로 이 경로만 예외로 둘
    이유가 없었다. 지금은 stop이 나가 공중에서 모터가 꺼진다.
    수동 킬 경로는 남는다 — 스크립트 stdin에 stop을 타이핑하면 즉시 컷이다.
    stop 전송 경로 표를 7개 전수로 확장했다. 드론 Armed=0 감지 경로는 유지하는
    근거도 적었다 — 하강 중에는 Armed가 1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
2026-07-27 feat(scripts): auto-land on gamepad disconnect too
    Fault_RC와 위험 구조가 같다. stop을 보내면 공중에서 모터가 꺼진다.
    수동 킬은 스크립트 stdin에 stop을 타이핑해 계속 가능하다.
    Fault_Critical, 수동 X버튼 disarm, Ctrl+C, 드론 Armed=0 감지는 disarm()을
    그대로 유지한다.
    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
2026-07-27 docs: failsafe auto-land, trim command, bench Stage E
    udp_protocol에 trim 명령과 Failsafe_Phase/Trim_Roll/Trim_Pitch를 넣고
    텔레메트리를 38필드/39열로 갱신했다. RC 타임아웃이 더 이상 즉시 컷이
    아니라는 점을 명시했다.
    power_on_bench_procedure의 Stage B-2는 기대 동작이 바뀌어 다시 썼고
    (0.5초 뒤 Failsafe_Phase 0→1, 5초 뒤 3), Stage E를 신설했다. 프롭 OFF
    상태 전이 → 중단 경로 → 손 파지 → 50cm 실착지 → 고도 단계 상승 순서이며
    E-4b로 낮은 스로틀 진입 시 적분기 리셋 관찰을 넣었다.
    ground_station_link에 게임패드 분리와 Fault_RC가 이제 자동착륙으로
    이어진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
2026-07-27 test(native): advance the fake clock per pid_task tick
    The failsafe state machine reads `elapsed = nowMs - fs_enter_ms`, but
    `arduino_fake::millis()` returned a frozen value and `runPidTicks` set no
    `pre_tick_hook`, so elapsed was constant across every tick of a call. No
    test ever drove a failsafe transition; deleting `fs_enter_ms = nowMs;`
    still passes.
    Adds `us_per_tick` to the shim (default 0, so existing manual clock hooks
    do not double-advance) and defaults `runPidTicks` to 1 ms/tick. Also
    rewrites the RC-return regression to a single `pid_task` call with hook
    injection -- re-entering `pid_task` had been re-running the descent
    locals and silently discarding the test's premise -- and co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
    [Arduino.h, test_control_math.cpp]
2026-07-27 fix(failsafe): detect touchdown by ground-reaction spike, not 1g return
    The land detector could never fire, and would have been wrong if it had.
    Three faults compounded. The `elapsed < min_descend` gate returned before
    the sub-1g branch, so it discarded the descent evidence the same function
    later required -- FS_CUT_LANDED was structurally unreachable. An
    accelerometer reads exactly 1 g in any constant-velocity descent, so
    "|accel| back at 1 g" is not a ground signal; the only unambiguous one is
    the ground-reaction spike, which the old code explicitly threw away as a
    contact artifact. And the +-0.05 g window is below the noise floor:
    across six recent logs only 85-94% of armed samples fall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
    [dual_imu_cascade_pwm.ino, test_control_math.cpp, test_failsafe_land.cpp]
2026-07-27 fix(scripts): split armed-belief from RC streaming, stop clobbering trim
    stop_streaming_only cleared is_armed, which silently disabled every kill
    path it was supposed to preserve. The X button re-mapped from disarm to
    arm -- pressing it at a descending drone sent start, and once the cut had
    landed that start was ACCEPTED, spooling motors on a drone in someone's
    hands. Ctrl-C's disarm became a no-op. The Fault_Critical rising edge and
    the Armed==0 watchdog, both deliberately kept as stop senders, sat behind
    `if is_armed:` and became unreachable after any auto-land entry. Two of
    the three manual kills documented in ground_station_link.md did nothing.
    is_streaming now gates transmission; is_ar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
2026-07-27 fix(failsafe): give fs_phase one writer, pin the descent's throttle window
    Four independent holes in the descent path.
    fs_phase was written from both cores, and pid_task's `if (fs_phase ==
    FS_DESCENDING) fs_phase = FS_CUT_ABORT;` is a non-atomic read-modify-
    write. If udp_task's start handler completed `fs_phase = FS_NONE;
    safety_lock = false;` inside that window, the aircraft came up armed with
    fs_phase latched at 4 -- making the entry guard permanently false and
    killing RC-loss detection for the rest of the flight: no auto-land, no
    cut, no fault_rc, just the last commanded attitude until the battery
    died. start no longer touches fs_phase; pid_task clears it on the first
    unlocked tick, so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
    [dual_imu_cascade_pwm.ino, test_control_math.cpp]
2026-07-27 docs: throttle-split failsafe entry, spike-based touchdown, bench Stage E
    Behaviour the code review changed and the docs still described the old
    way. RC-loss no longer always auto-lands: below FS_GROUND_THROTTLE_US it
    cuts immediately as it used to, so Stage B-2's expectation flips back and
    Stage E has to run above 1200 us. Touchdown is now a ground-reaction
    spike, not a return to 1 g -- an accelerometer reads exactly 1 g in any
    constant-velocity descent, so the old criterion could not distinguish a
    descent from contact even if the noise floor had let it fire.
    Stage E gains E-0 (the ground/air boundary), E-4c (a `th` arriving
    mid-descent must not raise the motors), and three constants to pi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
2026-07-27 feat(scripts): surface Failsafe_Phase and trim to the operator
    Stage E tells the operator to watch Failsafe_Phase live during a props-on
    descent, but neither monitor_telemetry.py nor analyze_flight_log.py
    referenced the field at all -- grep returned 0 hits in both. The bench
    procedure was unexecutable as written.
    The monitor now renders the phase by name and flags a non-zero phase
    prominently: an auto-land in progress is something the pilot has to know
    immediately, not decode from an integer. Trim is shown too, since the
    firmware owns it now and the ground station has no other way to confirm
    what the aircraft is actually holding.
    The analyzer reports phase transitions with timestamps, the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
2026-07-27 test(sil): give the plant vertical dynamics, then measure the failsafe
    The SIL accelerometer injected a pure gravity vector of magnitude exactly
    1 g -- no thrust, no ground reaction -- so |accel| could never be
    anything but 1 g and the land detector was unobservable here. That is why
    the detector's design flaws reached main.
    PlantState gains z and vz; thrust, a spring-damper ground contact, and a
    bounded ground-effect term drive them. The accelerometer change is one
    scalar: the existing unit gravity vector is multiplied by (a_z + g)/g,
    which is exactly 1.0 in equilibrium, so the injection stays bit-identical
    when vertical dynamics are off. They are opt-in per run, because existing
    attitude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
    [test_sil_attitude.cpp]
2026-07-27 feat(scripts): add --no-plot to the log analyzer
    plt.show() blocks the terminal until the window is closed, which makes
    skimming several logs during a bench session slower than reading the CSV
    by hand. Stage E asks the operator to check phase transitions and descent
    timing across repeated runs, so the text report needs to be usable on its
    own.
2026-07-27 test(sil): model real vibration, then close two vulnerabilities
    The SIL accelerometer carried only a 2 LSB dither, far cleaner than the
    0.03-0.05 g seen in flight, and false-positive scenarios read optimistic
    without it. Adds a deterministic low-frequency noise model (default off,
    bit-identical when off) matched to the measured spectrum: a 5 Hz filter
    must barely attenuate it, because in the real logs it does not -- the
    dominant content sits below 5 Hz, so a white-noise model would have been
    wrong by 8x.
    Two claimed vulnerabilities do not survive measurement:
    Ground effect cannot trigger a premature impact. Sweeping k_ge to 0.35
    -- past the 0.30 a real rotor sees -- peaks pre-contact |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
    [test_sil_attitude.cpp]
2026-07-27 fix(failsafe): descend relative to estimated hover, not entry throttle
    The descent target was entry_throttle - 60 us, which assumes the pilot
    was hovering when the link died. If they were climbing, entry - 60 is
    still above hover and the aircraft keeps going up. SIL V2 measured it:
    25.98 m of climb during a 5 s "auto-land", motors cut at 27.4 m.
    The firmware now estimates hover thrust continuously -- while armed,
    level, and vertically steady, the current throttle IS hover -- and
    descends relative to that. V2 now falls 1.78 m and reaches the ground.
    Nothing tied FS_GROUND_THROTTLE_US to hover either, so the fixed 1200 us
    ground-cut threshold sat only 140 us below the measured hover of ~1340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
    [dual_imu_cascade_pwm.ino, test_control_math.cpp, test_failsafe_land.cpp, test_sil_attitude.cpp]
2026-07-27 docs: replace v_z land detection with an active throttle probe
    Integrating accelerometer output from failsafe entry yields vz(t) -
    vz(entry), not absolute vertical velocity, so "vz returns to zero" only
    holds when the aircraft was already vertically still at entry. The
    scenarios it was meant to fix -- link loss while climbing or descending --
    are exactly the ones that violate that premise, and the implementation
    attempt confirmed it: V1 and V2 both timed out, and re-anchoring on
    contact let bounce push the estimate back to -0.22..-0.36 m/s.
    Accelerometer-only sensing cannot separate "resting on the ground below
    hover throttle" from "descending at terminal velocity": both read
    exactly 1 g, a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
2026-07-27 fix(failsafe): detect touchdown by probing, not by watching
    An accelerometer cannot separate resting on the ground from descending at
    terminal velocity -- both read exactly 1 g, and integration only yields
    velocity relative to failsafe entry, which is unknown. Every passive
    criterion tried so far either never fired or fired in mid-air.
    So ask instead of watch. During the descent the firmware periodically
    dips throttle 40 us for 120 ms and compares filtered |accel| against the
    reading just before the dip. On the ground the normal force absorbs it;
    in the air thrust drops and the aircraft accelerates down. Two
    consecutive non-responses confirm touchdown. Judging against the
    pre-dip baseline c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
    [dual_imu_cascade_pwm.ino, test_control_math.cpp, test_failsafe_land.cpp, test_sil_attitude.cpp]
2026-07-27 docs: drop the high-rate capture item
    Its justification was that a 10-100 ms touchdown spike aliases away at
    the 20 Hz telemetry rate. The active probe replaced that waveform with
    one scalar per probe, emitted every 400 ms as Failsafe_Probe_Response_G
    and therefore sampled about eight times each -- enough for the E-4a
    distribution measurement without a ring buffer.
    Kept as a contingency: if E-4a finds the ground and air distributions
    overlap, raw capture would help diagnose why, though a barometer would be
    the better answer at that point.
2026-07-27 docs: resume arrests the descent, it does not recover altitude
    The V6 acceptance criterion asked the aircraft to stop descending and
    hold altitude after resume. Restoring hover throttle zeroes the descent
    ACCELERATION; the velocity already accumulated remains, and holding
    altitude needs feedback the aircraft does not have. Same confusion
    between a rate and its integral that sank the v_z land detector.
    Quantified so the operational consequence is visible: the descent
    accelerates at -1.731 m/s^2, so resuming after 0.5 s still leaves
    -0.87 m/s and after 2 s leaves -3.46 m/s. Resume is worth less the longer
    it is delayed -- the pilot must resume promptly and then add throttle.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
2026-07-27 fix(failsafe): one writer for safety_lock, and a way back from a descent
    safety_lock had the same cross-core race fs_phase used to: pid_task locks
    on over-tilt, IMU loss, and auto-land end while udp_task unlocks in
    start. If start's write landed between pid_task's fault detection and its
    lock, the aircraft came up armed with a latched fault. Core 0 now only
    requests; Core 1 performs the transition under a spinlock, and a pending
    disarm always beats a pending arm.
    This is a partial fix and worth saying so: start still initialises fault
    latches, the throttle window, and angleZ from Core 0. Only the lock
    transition moved.
    An auto-land was also a one-way door -- the link could come back and th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
    [dual_imu_cascade_pwm.ino, test_control_math.cpp, test_sil_attitude.cpp]
2026-07-27 fix(failsafe): stop cancels a queued resume
    Found by an adversarial re-audit. `resume` and `stop` arriving before the
    same pid tick left the resume request pending: the safety_lock block
    `continue`s before the resume is consumed, so it survived the disarm and
    sat latched. The next time the aircraft armed and entered an auto-land,
    that stale request from an earlier flight could cancel the descent --
    clearing fault_rc and restoring hover throttle -- provided RC happened to
    be alive at that instant.
    requestSafetyDisarm now clears it, so a kill command cannot be
    outlived by a recovery command it was meant to override.
    Mutation-verified: dropping the clear fails the new case, and the request
    vi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
    [dual_imu_cascade_pwm.ino, test_control_math.cpp]
2026-07-27 feat(scripts): make the resume path reachable from the ground station
    The firmware gained a `resume` command, the protocol doc described it,
    and Stage E had a step to verify it -- but control_dualsense.py never
    sent it, and could not have. is_streaming is set true only inside arm(),
    auto-land entry clears it, and arm() is refused while the drone is still
    armed, so RC streaming never restarted. The firmware requires RC alive
    for resume, which meant every attempt would have answered
    RESUME REFUSED rc. The word "resume" appeared zero times in the file.
    Recovery is now an explicit triangle press (or `resume` on stdin) driving
    a small state machine: restart RC streaming, wait for telemetry to
    co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
2026-07-28 test(native): cover the in-flight over-tilt cut
    Disabling the over-tilt guard entirely left the whole suite green, so the
    one path that stops a tumbling aircraft was unprotected by tests. Adds a
    case per axis that arms, confirms all four motors are above idle, injects
    SAFETY_ANGLE+10 on one axis, and requires fault_attitude, safety_lock,
    four motors back at 1000, and exactly one log line.
    Mutation-verified per branch: disabling only the roll term fails only the
    roll case, and likewise for pitch.
    Found by an adversarial re-audit.
    [test_control_math.cpp]
2026-07-28 docs: record the second-round audit and the measured probe fix
    The probe dip is absolute while the descent target is relative to
    estimated hover -- the same mistake 1-B fixed, left in the other half.
    Probe signal scales as dip/(hover-1000), so a heavier aircraft gets a
    weaker probe: at 1.3x mass the response falls from 11.8% to 9.05% of
    thrust and sinks into the noise.
    Measured across 100 entry noise phases: mid-air cuts appear at 4% (sd
    0.04g), 6% (0.06g) and 12% (0.08g) at 1.3x mass, and 23% at 1.6x, while
    nominal mass stays at 0% throughout. Restoring the dip to a constant
    FRACTION of hover thrust returns every mass from 0.7x to 1.6x to 0%.
    Also records hover-estimator contamination cau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
2026-07-28 fix(failsafe): scale the probe dip to hover, and stop trusting hover twice
    Four defects from the second-round audit.
    The probe dip was absolute while the descent target is relative to
    weaker probe: at 1.3x mass the 40 us dip falls from 11.8% of thrust to
    9.05% and sinks into the noise. Sweeping 100 entry noise phases, mid-air
    FS_CUT_LANDED appears at 4% (sd 0.04g), 6% (0.06g) and 12% (0.08g) at
    1.3x mass and 23% at 1.6x, while nominal mass stays at 0%. The dip is now
    a fixed fraction of hover thrust, clamped at runtime since it can no
    longer be a stati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
    [dual_imu_cascade_pwm.ino, test_control_math.cpp, test_failsafe_land.cpp, test_sil_attitude.cpp]
2026-07-28 docs: third audit -- soft ground defeats the probe
    Audited the paths the second-round fixes created. Most held: the resume
    budget does reset on re-arm, the ground station has no lock inversion,
    the dip clamp bounds are unreachable in practice, stop cancels a pending
    arm, and the bounce property survived the 1 g veto. Four coverage
    mutations were all caught.
    The absolute 1150 us ground cut is not the bench regression it looked
    like -- the previous relative rule compared throttle against an estimate
    learned from that same throttle, so hand-held work essentially never
    ground-cut at all. The absolute rule closes that.
    What did not hold is soft ground. Across 36 combinations of contact
    stiffnes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
2026-07-28 docs: fix Stage E-4a so its measurement is valid
    Two ways the procedure as written would have produced meaningless
    numbers.
    The dip is 0.118 x (Hover_Est - 1000), and a hand-held aircraft satisfies
    every hover-candidate condition -- level, about 1 g, throttle above 1150
    -- so simply holding it teaches the estimator the hand-held throttle.
    Measuring "air" response that way uses a 30 us dip against the 40 us the
    aircraft will actually fly with, and the two distributions being compared
    are then taken under different conditions. E-4a now requires establishing
    Hover_Est by real hover and confirming it is unchanged across every
    sample.
    And contact stiffness turned out to be the only variable tha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
2026-07-28 fix(failsafe): refuse trim changes during an auto-land
    The descend block applies trim_roll/trim_pitch as the attitude target on
    every tick, but the trim handler had no armed gate, no phase gate and no
    sequence number. A single `trim 10 -10` datagram arriving mid-descent set
    the bank angle of an aircraft the pilot cannot steer.
    The design document quantifies 2 degrees as 4.3 m of drift and 1.71 m/s
    of horizontal speed at touchdown, and calls that destructive to the
    gentle-landing goal. The clamp allows 10 degrees: 21.6 m and 8.65 m/s
    over a five-second descent.
    Flagged in the original code review as "trim is accepted while armed" and
    never closed; moving trim into the firmware and then usin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
    [dual_imu_cascade_pwm.ino, test_control_math.cpp]
2026-07-28 fix(failsafe): no configuration changes while the aircraft is landing
    An exhaustive pass over every UDP command found 22 more that a descent
    accepted. All 21 PID gain commands take effect immediately with no armed
    gate, no phase gate and no sequence number, so a datagram can retune the
    attitude loop of an aircraft nobody is flying -- `dr 100` was reproduced
    dynamically in SIL. `magc` sets magnetic-interference coefficients from
    unbounded floats, shifting mag heading and angleZ, which then commands
    yaw against the heading the descent is trying to hold.
    Rather than 22 separate guards, this is one rule with one helper: nothing
    that configures the aircraft may change while it is descending. Add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
    [dual_imu_cascade_pwm.ino, test_control_math.cpp]
2026-07-28 fix: hold one lock over throttle state, and let one core own the estimator
    The resume throttle sync was implemented but not thread-safe. The
    telemetry thread wrote throttle_f and current_throttle under telem_lock;
    the controller thread read-modify-wrote throttle_f with no lock at all,
    unconditionally, on every 20 Hz tick. A one-sided lock is not mutual
    exclusion, so the sync could be silently lost -- and if only
    current_throttle survived, the very next tick saw a mismatch and sent
    `th 1000`, dropping a just-recovered aircraft to idle thrust at low
    altitude. That is the exact failure the sync exists to prevent.
    Both values now change together inside telem_lock, with send_cmd moved
    outside it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
    [dual_imu_cascade_pwm.ino, test_control_math.cpp]
2026-07-28 fix(failsafe): pin the probe's sensitivity to the constants that set it
    The active-landing probe decides "airborne" when the dip response exceeds
    FS_PROBE_RESPONSE_G, but the size of that response is set by
    FS_LAND_LPF_ALPHA:
    response = FS_PROBE_DIP_FRAC * (1 - exp(-FS_PROBE_DIP_MS * alpha / 1ms))
    SIL V2 at 2-3 m altitude measures 0.1146g at alpha=0.03, 0.0789g at 0.01,
    and 0.0464g at 0.005 -- below the 0.060g threshold, where the no-response
    counter reaches its confirm threshold at 3.08 m. Nothing guarded that
    coupling, and the only test that failed when alpha dropped asserts the
    filter passes noise through, so its failure reads as an invitation to
    relax it.
    The 1g veto does not cove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
    [dual_imu_cascade_pwm.ino, test_control_math.cpp, test_failsafe_land.cpp]
2026-07-28 fix(failsafe): make sure the probe dip actually reaches the motors
    The active-landing probe dips collective and reads the accelerometer to
    decide airborne-vs-ground. mixAndDesaturate clamps collective into
    [minMotor - minDiff, maxMotor - maxDiff] to protect attitude authority, so
    a large attitude differential raises the floor and eats the dip. Running
    the real mixer over the descent window (1280us, +/-CTRL_MARGIN, 40us dip):
    loss starts at |minDiff| > 110us and the dip is gone entirely at 150us.
    150us is a designed operating point, not an extreme. I_TERM_MAX_US is 50us
    per axis and diff[0] = -pitch + roll - yaw, so three saturated integrators
    at (-50, +50, +50) land exactly on -150. Integra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
    [dual_imu_cascade_pwm.ino, test_control_math.cpp, test_failsafe_land.cpp]
2026-07-28 feat(bench): give Stage E something that can actually read the probe
    Every Stage E step reads telemetry fields 39-43, and no ground tool
    displayed or analysed any of them:
    grep -c Hover_Est scripts/monitor_telemetry.py -> 0
    grep -c Hover_Est scripts/analyze_flight_log.py -> 0
    They were written to CSV and read by nobody. E-0 gates all of Stage E on a
    live Hover_Est/Hover_Valid, E-3 watches the no-response count, and E-4a
    wants ground and airborne response distributions of n>=20 each compared
    against a 0.011g margin. None of that was doable. This is the same gap
    Layer 0's 0-C closed for Failsafe_Phase; the fields added in rounds 3-5
    never got consumers.
    monitor_telemetry now show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
2026-07-29 feat(bench): show the auto-land state on the tool that is actually listening
    The firmware retargets telemetry to the sender of every incoming packet:
    dual_imu_cascade_pwm.ino:1540-1543
    if (packetSize) {
    laptopIP = udp.remoteIP();
    laptopPort = udp.remotePort();
    Stage E needs an RC stream right up to the moment it is cut, and
    control_dualsense is what sends it, so during Stage E telemetry goes almost
    entirely to that script. A second tool competing with a 1 Hz connect
    against a 50 Hz RC stream receives nearly nothing, which means the probe
    fields added to monitor_telemetry cannot be read during the stage they were
    added for. Found by flashing and watching the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
2026-07-29 fix(gs): report what the RC timeout actually did, not what it usually does
    The rising-edge notice was hardcoded to "자동착륙 진행 중". The firmware
    splits three ways on RC timeout: no valid hover estimate cuts immediately,
    throttle at or below FS_GROUND_CUT_MAX_US cuts immediately, and only the
    remaining case descends. The first two stop the motors, so the message was
    false for two of three outcomes.
    At the bench that is confusing. In flight it inverts the operator's model:
    they believe the aircraft is descending under control while it is actually
    a dead-stick drop, so they reach for neither resume nor the physical kill.
    Failsafe_Phase and Armed are already in the same sample. Read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
2026-07-29 docs(bench): record what the hardware said, including where the SIL was wrong
    First powered bench session on 3ea9ca6. Every auto-land timing constant
    matched: min descend 1000ms, probe period 399ms by timestamp, descent delta
    60us, applied dip 20.05us against a requested 20, and landing confirmed at
    1.55s against a predicted 1520ms.
    Two claims in the strategy document turned out to be wrong in the direction
    that matters.
    The SIL overestimates ground probe response on hard surfaces. This document
    worried repeatedly about the 0.011g gap between the worst SIL ground
    response and the best SIL airborne response. A weighted-down airframe with
    props running measures 0.0010-0.0040g, a 15-60x margi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
2026-07-29 docs(bench): B-1 passes, and note the two ways it looked like it had not
    All twelve gains read back matching the sketch declarations, including the
    Ki_Rate_Roll/Pitch = 0.05 that B-1 asks for.
    Getting there took two detours worth recording. tune_pid is the only script
    that prints a GAINS reply -- control_dualsense, monitor_telemetry and
    receive_telemetry all filter it out with is_gains_packet and continue -- so
    typing gains into the tool Stage E forces you to use produces silence no
    matter how healthy the link is. And control_dualsense prints nothing at all
    before arming, because DIAG needs is_armed, AUTO-LAND needs a nonzero
    phase, and the fault notices are edge triggered. Together those m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
2026-07-29 feat(gs): make control_dualsense the only ground station you need
    The firmware points telemetry at whoever sent the last packet, and
    control_dualsense is the only tool that streams RC, so during any stage
    that needs RC nothing else receives anything. Two ground tools cannot
    coexist. But the bench procedure kept asking for things control_dualsense
    could not do, so the operator switched to tune_pid -- which streams no RC,
    so the aircraft armed and RC-timed-out half a second later. That happened
    for real today.
    The trap that mattered most: stdin "start" fell through to send_cmd.
    "stop" and "resume" were routed to disarm() and request_resume(), but
    "start" was not, so the drone armed while the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
2026-07-29 docs(bench): B-2 and C-1/C-2 pass; the calibration spread is a trend, not noise
    Props are on and the sign chain confirmed by telemetry numbers on 07-24 now
    holds as physical thrust: the aircraft pushes down at 1080, and tilting it
    produces a felt reaction from the motors that rise. B-2 is complete across
    all four kill paths. C-3 is the only Stage C item left, and the only thing
    in the whole procedure that nothing else can settle -- SIL S5/S6b leave the
    plant's yaw reaction torque sign unresolved.
    Three boots now, and the calibration numbers move one direction every time:
    accel scale 0.993153 to 0.995544 to 0.998702, gyro bias Z climbing with it.
    Calling that 0.24% repeatability after two bo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
2026-07-29 fix(gs): show Yaw_Hold, which C-3 asks the operator to read
    Field 35 was written to CSV and displayed nowhere. Stage C-3 steps 4 and 5
    turn on it -- release the stick, watch Yaw_Hold go 0 to 1 as the yaw rate
    settles, confirm the stopped heading holds and does not bounce back -- and
    the bench procedure's own field list in section 1 names it. Today the
    operator went looking for it mid-test and it was not there, so those two
    steps could not be judged.
    It now appears in both the 1Hz STATUS line and the 5Hz DIAG line. DIAG
    already carries gZ, tY and the yaw-axis motor differential, so the settle
    threshold and the flag it drives are readable side by side.
    Fourth display gap this session, all th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
2026-07-29 feat(telem): log IMU1 and IMU2 separately, in the fused frame
    The 20Hz stream only carried the average of the two IMUs, so nothing on
    the ground could tell whether IMU2 was healthy, or which sensor the
    per-boot accel-scale drift (0.993 -> 0.995 -> 0.999 across three boots)
    was coming from. g1/g2/a1/a2 existed only as pid_task locals.
    Append twelve fields (44-55). They are converted with the same body
    transform and ACCEL_SCALE the fused values use, not shipped in the IMU1
    sensor frame, so that
    Active_IMUs=2 && !Fault_Disagree => Gyro_X == (IMU1_Gyro_X + IMU2_Gyro_X)/2
    holds in every row. That identity is the self-check: an axis or sign
    mistake in this code shows up in the log instead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
    [dual_imu_cascade_pwm.ino, test_control_math.cpp, test_sil_attitude.cpp]
2026-07-29 feat(telem): stream raw dual-IMU registers at 1kHz over batched UDP
    The 20Hz per-IMU fields added last commit sample a 1kHz loop once every
    fifty iterations, so the prop band aliases and nothing about vibration,
    transient disagreement, or freeze is recoverable from them. The loop
    already runs at 1kHz; only the transport was missing.
    One datagram per sample would be 1000 pkt/s and would bury the 50Hz RC
    stream. Batching fifty 26-byte records into one 1320-byte datagram puts
    full-rate capture at 20 pkt/s -- the same packet rate the ASCII stream
    already costs -- for 26 KB/s instead of 5.3.
    Ship the int16 register counts, before sign, scale, bias, LPF, and the
    body transform. Half the bytes of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
    [WiFiUdp.h, dual_imu_cascade_pwm.ino, test_control_math.cpp]
2026-07-30 docs(bench): stage the raw stream through Stage E instead of banning it
    I told the spec to turn the 1kHz stream off for all of Stage E, and gave
    RF contention with the 50Hz RC stream as the reason. FS_DESCENDING is
    entered only from rcTimedOut() (.ino:1318), so RC is already gone by
    then and that reason does not apply to the phase it was aimed at.
    The stronger argument runs the other way. The probe decides on a 0.06g
    differential across a 120ms dip: 2-3 samples at 20Hz, 120 at 1kHz. R6
    (soft ground never confirms touchdown) and R13 (the mixer absorbing the
    dip) are both unconfirmed on hardware, and a 1kHz record is the only
    thing that could explain either one from a real descent. Banning it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
2026-07-30 feat(telem): log the commanded attitude, not just the rate it produced
    The log carried TgtRate_Roll/Pitch/Yaw -- what the outer loop asked the
    rate loop for -- but never the angle that was commanded, so the tracking
    error the outer loop is actually closing could not be reconstructed from
    a recording. targetAngleX/Y/Z already existed as volatile floats; they
    were simply never sent.
    Three fields (56-58), forwarded as-is. Three things about them are easy
    to misread, so they are written down in the protocol doc:
    - trim is already folded in (targetAngleX = constrain(x + trim_roll,
    ...)), so adding Trim_Roll on top double-counts it
    - under autoland these carry trim_roll/trim_pitch/fs_hol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
    [dual_imu_cascade_pwm.ino, test_sil_attitude.cpp]
2026-07-30 feat(telem): stream raw by default and hand back a CSV on exit
    Bench measured the 1kHz stream at 999.999 Hz with zero wireless loss and
    zero producer drops over 219 batches, so there is no reason to make the
    operator remember to switch it on.
    Default-on needs one thing fixed first. The consumer refuses to send
    until connectionEstablished, but the producer had no such gate, so
    between boot and the ground station's first packet the ring would fill in
    512ms and then drop continuously -- the first STATUS would show thousands
    of drops that mean nothing, and a count that fires when nothing is wrong
    cannot be used to detect when something is. Gate the producer on it too.
    That makes connectionEstab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
    [dual_imu_cascade_pwm.ino, test_control_math.cpp]
2026-07-30 fix(yaw): hold a heading through a disturbance instead of surrendering it
    updateYawOuter recomputed hold from scratch every tick, so it could not
    tell "the pilot just released the stick mid-spin" from "something pushed
    a heading we were holding". Both arrive as centered stick plus rotation.
    It treated them alike: above YAW_HOLD_SETTLE_DPS the lock dropped and the
    setpoint was overwritten with the current heading, the rate loop damped
    the spin to rest, and hold re-engaged wherever the aircraft ended up.
    One disturbance past 10 dps therefore reassigned the heading for good.
    Damping made it feel controlled while the heading quietly went away,
    which is what "yaw hold isn't working" on the bench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
    [dual_imu_cascade_pwm.ino, test_sil_attitude.cpp, test_yaw_command.cpp]
2026-07-30 feat(gs): let the operator see and control mag fusion
    arm() sent a hardcoded "mag 1" before every start, so fusion was on for
    every flight whether anyone meant it or not, and typing "mag 0" only held
    until the next arm quietly turned it back on. The command reached the
    drone through the generic stdin passthrough but was absent from the help
    line, so there was little reason to think it existed.
    Worse, nothing showed whether it took. "mag 1" can be refused outright --
    first init is rejected while armed -- or simply lost, and MagHeading
    keeps its last value after fusion stops, so it cannot answer the
    question. Append Mag_Enabled as field 59 and read [STATUS] Mag= from
    that, never from what the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
2026-07-30 fix(gs): default mag fusion back on, which is the verified configuration
    I set the new default to off on the grounds that the BMM350 heading
    check was still outstanding. It was not. docs/bmm350_yaw_bench_test.md
    records all four steps finished 2026-07-27 and concludes mag-yaw
    heading-hold is usable in flight; I read a stale index line instead of
    the repository.
    Gyro-only is also the weaker configuration, not the safer one. Rotation
    below YAW_DEADZONE=0.3 dps -- 18 degrees a minute -- never reaches
    angleZ at all, so heading hold sees no error and issues no correction,
    and with fusion off nothing recovers it. The auto-"mag 1" that arm() used
    to send was deliberate and matched that conclusion;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
2026-07-30 fix(gs): stop trim presses from stalling the RC uplink, and show what landed
    send_trim() went through reliable_send, which loops STOP_RETRIES times
    sleeping STOP_INTERVAL between sends -- 100ms of blocking. It is called
    from controller_thread, the same thread that sends rcr at 50Hz, so every
    D-pad press cut the RC uplink for a tenth of a second against a 500ms
    watchdog. TRIM_STEP is 0.2 degrees and the standing error measured at
    the bench is 5-6, so nulling it takes about thirty presses; five quick
    ones are already a timeout.
    Send once instead, and cover loss by comparing against telemetry rather
    than by blind repetition: trim is an absolute command, not an increment,
    so resending is safe.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
2026-07-31 docs(flight): record the first real flight, and what 20Hz hid
    176s armed, zero fault flags, and the three fixes from that day all
    behaved in the air: yaw hold stayed locked 91.9% of the flight with 28
    of its 30 releases below 10 dps -- releases the pre-latching code could
    not produce, since it dropped the lock on disturbance instead.
    Two things only the 1kHz log could say.
    The 20Hz dG field understates disagreement by about 8x. Same flight, three
    ways: 20Hz reports a 3.69 dps maximum and no crossing of the 15 dps
    threshold; the raw log says 89.65, and 30.80 once the firmware's own 80 Hz
    filter is replayed over it, crossing seventeen times. That last figure is
    the one the firmware compares,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
2026-07-31 fix(failsafe): require four no-response probes, and write down why that is not enough
    Autoland cut the motors in mid-air on 2026-08-01. Post-cut |accel| fell to
    0.714 g and then spiked to 1.392 g on impact; a landed airframe holds a
    steady 1.0 g. Over the 4.75s descent the probe evaluated eight times, all
    of them airborne, and three read below the 0.06 g threshold. Two in a row
    ends the descent, so at a ~38% false rate the cut was going to happen
    within a few cycles no matter the altitude.
    Replaying the firmware's own filter over the 1kHz log shows why. With no
    dip applied at all, the 120ms drop in filtered |accel| reaches p95
    0.0904 g in hover -- larger than the whole threshold. Disturbanc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
    [dual_imu_cascade_pwm.ino, test_control_math.cpp, test_sil_attitude.cpp]
2026-07-31 test(failsafe): untie the probe tests from the constants they were meant to guard
    Trying to retune the probe from the 2026-08-01 flight data ran into four
    tests that had the old parameters baked into them, so any change to those
    parameters broke them for reasons unrelated to what they were checking.
    The dip-size cases hardcoded 40us and 52us, which are just
    FS_PROBE_DIP_FRAC times the hover margin; they compute it now. The
    LPF case asserted that alpha=0.005 puts the response under the threshold
    -- true at 0.06, meaningless at 0.03 -- when the invariant it exists to
    protect is that lowering alpha lowers sensitivity. That is now a
    monotonicity check, with a separate lower alpha still covering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
    [dual_imu_cascade_pwm.ino, test_control_math.cpp, test_failsafe_land.cpp]
2026-07-31 fix(sil): model a floor the drone actually lands on, then lower the probe threshold
    Retuning the probe threshold from flight data hit a wall: no value
    satisfies both the simulator and the aircraft. The SIL needed above
    0.0512 g to ever confirm a landing; avoiding the observed mid-air cut
    needed below 0.0070 g. Empty intersection.
    The simulator was wrong. k_ground was 80 N/m, which is 4.25 cm of static
    deflection -- a foam mat, not a floor. Its ground probe response came out
    at 0.0464-0.0512 g against 0.0010-0.0040 g measured on the bench with
    props running and the airframe weighted down. That tenfold gap is why the
    harness blessed a 0.06 threshold that then cut the motors in mid-air.
    Swept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
    [dual_imu_cascade_pwm.ino, test_sil_attitude.cpp]
2026-07-31 fix(failsafe): stop asking the probe where the ground is; descend on a timer
    The threshold change flew, and produced the opposite failure: the drone
    landed and the probe never noticed, so the props kept turning until the
    backstop. That flight is the ground label the whole analysis had been
    missing, and with it the question closes.
    air (proven by post-cut freefall) 0.0070-0.1340 median 0.0800
    ground (touchdown observed) 0.0590-0.1930 median 0.1020
    Ground responds more than air. The discriminant is not weak, it is
    inverted, and the best threshold available still misclassifies nine of
    eighteen -- a coin toss. No value works, so no amount of tuning was ever
    going to f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
    [dual_imu_cascade_pwm.ino, test_control_math.cpp, test_sil_attitude.cpp]
2026-07-31 feat(telem): stamp the failsafe phase into the raw stream so logs can be cut by it
    Chasing a touchdown discriminant ran out of road for a mundane reason:
    the 1kHz capture carries firmware micros() and the 20Hz CSV carries PC
    wall clock, with nothing in common. Two flights with known ground truth
    are on disk and neither can be windowed to its descent, so every
    candidate that needs the descent -- gyro impact signature being the last
    one standing -- is untestable.
    One byte per sample fixes it. ImuRawSample grows to 27, the datagram to
    1370, still comfortably inside the MTU at fifty samples per batch, and no
    batch-size change is needed. The value is read a tick before fs_phase is
    reassigned, so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
    [dual_imu_cascade_pwm.ino, test_control_math.cpp]
2026-07-31 docs(failsafe): rule out every IMU-based touchdown discriminant with measurements
    The phase byte did its job. With the 1kHz log cuttable to the descent,
    four labelled descents were available -- three landings, one proven
    airborne throughout -- and every candidate could finally be tested
    instead of argued about.
    Six are dead. The dip response has its sign inverted. The return of
    |accel| to 1 g is terminal velocity, not contact: the airborne flight did
    it at t=1.0s and fell for another 3.7s. Velocity integration drifts a
    metre per second in four. The accel impact spike cannot survive a 25 Hz
    hardware filter -- the rise times measured were the filter's own step
    response. The HF/LF ratio overla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
2026-07-31 fix(failsafe): retract the mid-air-cut finding, and size FS_MAX_MS from measurement
    The claim that autoland cut the motors in mid-air was wrong, and it drove
    most of a day's work. It rested on one 20Hz sample reading 0.714 g after
    the cut, taken for free-fall onset. The same interval at 1kHz sits between
    0.97 and 1.05 g from 200 ms before the cut to 650 ms after, and the pilot
    confirmed the aircraft was down. That cut happened on the ground, which is
    what it is supposed to do.
    Everything that leaned on labelling 010251 as airborne goes with it: there
    were no airborne probe samples at all, so "ground responds more than air",
    "the sign is inverted", "nine of eighteen", and the negative contro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
    [dual_imu_cascade_pwm.ino, test_sil_attitude.cpp]
2026-08-03 feat(sensor): read the 3901-L0X into telemetry, and let it decide nothing yet
    The rangefinder is what the whole landing-detection investigation
    concluded it needed, so the temptation is to wire it straight into the
    cut. Today's lesson argues against that: a single mis-read 20Hz sample
    sent a day of work down the wrong path. This stage only logs.
    The parser lives in msp_sensor.h so the native suite can pin it. Twelve
    cases cover CRC, resynchronisation after garbage, a '$' arriving where
    'X' was expected, frames split across reads, all three direction bytes,
    and payloads larger than the buffer -- those are consumed rather than
    stored so the stream stays in sync. The test builds its own frames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
    [Arduino.h, dual_imu_cascade_pwm.ino, test_control_math.cpp, test_msp_sensor.cpp, test_sil_attitude.cpp]
2026-08-03 feat(mag): replace min/max hard-iron with constrained ellipsoid calibration
    min/max was not merely crude, it was worse than no calibration. On
    ground-truth synthetic data (20 runs/condition) it made |B| spread
    6.8% -> 14.5% and cost 17 deg of heading on a realistic hand rotation;
    15 spike samples out of 1500 broke it in 13/20 runs (median 56 deg).
    The cause is structural: it reads only the 2 extreme samples per axis,
    so nothing averages.
    Worse, the result could not be checked. startMagCalibration() cleared
    mag_enabled, but magTelem{X,Y,Z} were only written under mag_enabled,
    so the magnetic telemetry froze for the whole capture. The raw samples
    never left the board and the only output was t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
    [dual_imu_cascade_pwm.ino, test_control_math.cpp, test_mag_yaw_fusion.cpp, test_sil_attitude.cpp]
2026-08-03 docs(mag): record bench step 4 pass, and why a monotonic ramp cannot judge it
    The W @ old conversion of the mag_comp throttle coefficients now has
    hardware behind it: MagHeading slope -0.067 deg/100us (corr -0.030),
    Mag_X residual +0.0008 uT/us, i.e. -0.24 deg at hover. That matches the
    +0.02 deg/100us measured on 2026-07-27 before the soft-iron change.
    Coefficients were left alone; the residual regression only reaches corr
    0.2-0.25, so fitting it would learn noise.
    The first attempt got this wrong and it is worth recording. A ramp that
    only climbs makes corr(throttle, time) = 0.992, so throttle-driven
    interference and slow drift are the same regressor. That run reported
    +0.93 deg/100us and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
2026-08-09 fix: harden magnetometer calibration telemetry
    [dual_imu_cascade_pwm.ino, test_mag_yaw_fusion.cpp]
2026-08-09 fix: move Yaw fusion slide into heading section
2026-08-09 docs: clarify touch sensor boundary
2026-08-09 fix: harden mobile lab classroom flows
2026-08-14 docs: clarify optical-flow angular velocity
2026-08-17 docs: show yaw drift over time on slide 51
2026-08-17 docs: clarify slide 10 yaw control
2026-08-18 docs: replace torque diagram with standalone SVG
2026-08-18 fix: ground drone production estimate
2026-08-24 docs: say what the auto-land actually does, and stop citing a retracted finding
    The auto-land description had drifted into a safety lie. udp_protocol.md still
    explained landing as a probe decision -- "two consecutive no-responses cut at
    Phase=2", threshold 0.06g, FS_MAX_MS=5000 raised to 10000 after bench
    verification. None of that is the firmware. Since 02112df/07231eb the probe is
    wired to `const bool landed = false` and the descent is purely timed at
    FS_MAX_MS=3000, so Phase=2 is unreachable and Phase=3 is the normal exit. A
    reader sizing a test altitude off that document would have sized it off 5-10s
    of descent budget instead of 3.
    Also: FS_RESUME_MAX_MS said 15s (it is 3 x 3000 = 9s),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
    [dual_imu_cascade_pwm.ino]
2026-08-24 chore: hand the presentation material over to its own repository
    The AI startup camp deck had grown to more than half this repo's tracked files.
    Firmware changes and slide tweaks shared one commit log, one CI run and one docs
    index, and the CI had been red since 2026-08-19 for reasons that had nothing to
    do with the aircraft: Manim, python-pptx and matplotlib were missing on the
    runner, and one launcher test was pinned to a path on my laptop.
    Everything presentation-shaped now lives in lightminn/zetin-drone-presentations
    with its history intact -- both decks, the mobile lab, the Oracle hosting tools
    and runbook, their test suites, and the dated design records for all of it.
    This repo is fir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
2026-08-24 ci: install what the firmware and tests actually need
    Splitting the presentation out cleared 30-odd noisy failures and left two real
    ones that had been hidden underneath.
    The firmware job has not compiled the main sketch since 2026-07-24. That is when
    430f7cf added #include <DFRobot_BMM350.h>, and the lib install line was never
    updated, so every run since has died at "No such file or directory" -- a month
    with no compile verification. The library is not in the Arduino index (it is a
    user install from DFRobot's GitHub here), so CI installs it by git URL, which
    needs enable_unsafe_install. Cache key bumped so the old entry is not reused.
    The python job installed only numpy, but scripts/fails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
2026-08-24 ci: install the declared dependency set instead of guessing at it
    Adding matplotlib got test_failsafe_telemetry collected, and then it failed on
    pandas -- the module imports one and the subprocess it drives needs the other.
    Picking packages one at a time was always going to walk into this, so use
    requirements.txt, which is where the ground station dependencies are already
    declared. scripts/ imports exactly numpy, pandas, matplotlib and pygame, all
    four of which that file lists, so the two lists can no longer drift apart.
2026-09-07 docs: align project status and workflows with the current code
    Refresh the README, onboarding guides, protocol and bench documentation, and PID comparison PDF. Distinguish main behavior from tether experiments and correct stale source comments without changing runtime behavior.
    Validated 175 tests, 9 Arduino sketches with ESP32 core 3.3.7, document links, PDF rendering, and comment-only code equivalence. Record the completed Notion audit and preserve dated experiment records.
    [dual_imu_cascade_pwm.ino, test_control_math.cpp, test_sil_attitude.cpp]
